thomashiemstra/fred/README.md

## Fred the robot arm

Table of Contents
-----------------
  * [Obstacle avoidance with reinforcement learning](#Obstacle-avoidance-with-reinforcement-learning)
  * [Algorithm details](#Algorithm-details)
  * [Deploying in the real world with machine vision](#Deploying-in-the-real-world-with-machine-vision)
  * [Videos](#Videos)
  * [Inverse kinematics](#Inverse-kinematics)
  * [Record and play back with a controller](#Record-and-play-back-with-a-controller)
  * [Motion tracking](#Motion-tracking)
  * [Physical robot details](#Physical-robot-details)
  * [Control panel](#Control-panel)

## Obstacle avoidance with reinforcement learning
A quick overview can be seen in [this](https://www.youtube.com/watch?v=u2XVU5J9dac) youtube video  
Using deep reinforcement learning the robot can reach the goal whilst avoiding obstacles, it even outperforms a classical method (gradient descent). 

Gradient descent (left) vs trained agent (right):

<p float="left">
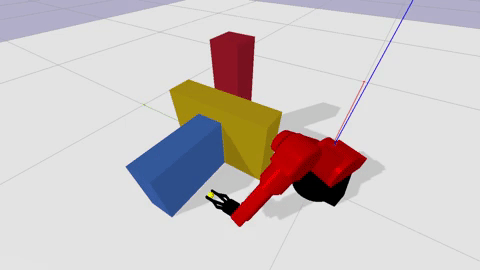
[picture p1: media/gd.gif]
  
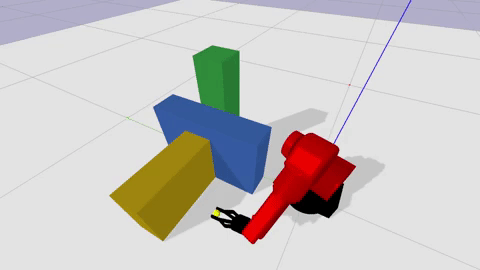
[picture p2: media/RL.gif]
  
</p>

With gradient descent the robot simply gets stuck. The trained agent manages to complete the task and can even be deployed on a real robot:



## Algorithm details
The goal is to get the robot to move from point A to point B without bumping into obstacles. 
A classical method is to use workspace potential fields and gradient descent, which is just a fancy name for 
pulling the robot towards the target and pushing it away from obstacles. However, the robot can get stuck when the net force is zero. 
The input for the gradient descent algorithm are 2 types of vectors: attractive vectors pointing towards the goal position and repulsive vectors pointing away from obstacles. 
These vectors originate from control points that have to be chosen manually:
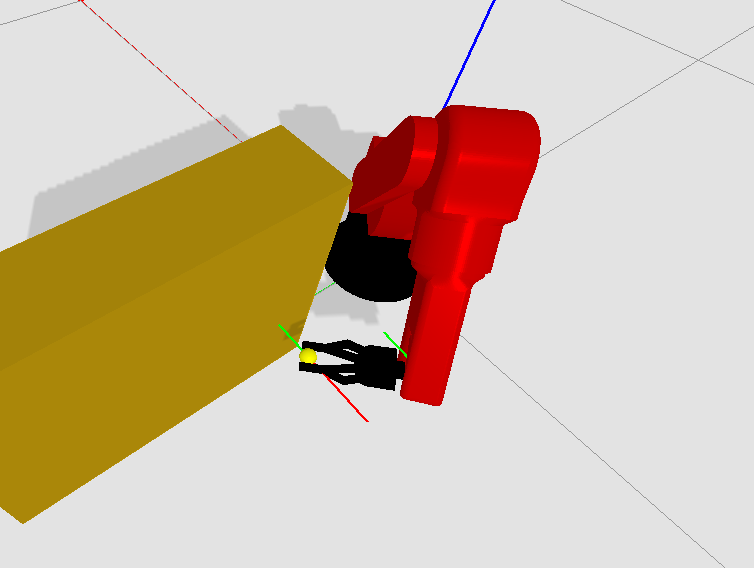
[picture p3: media/gradientDescentVectors.PNG]


If the net force on the robot is zero it gets stuck. I cannot "see" the obstacle except when it gets close to it.

This is where the idea of using reinforcement learning came from. We can give the agent the same inputs as gradient descent, 
but we can also make it aware of its current position and obstacles it's about to face, both their size and location. 
In theory, it could then plan its movement ahead and avoid the obstacle without getting stuck. The idea is to take the obstacles 
and turn them into an occupancy grid which is then fed into the network as an image using convolutional filters 
(here color corresponds to the height of the obstacle):
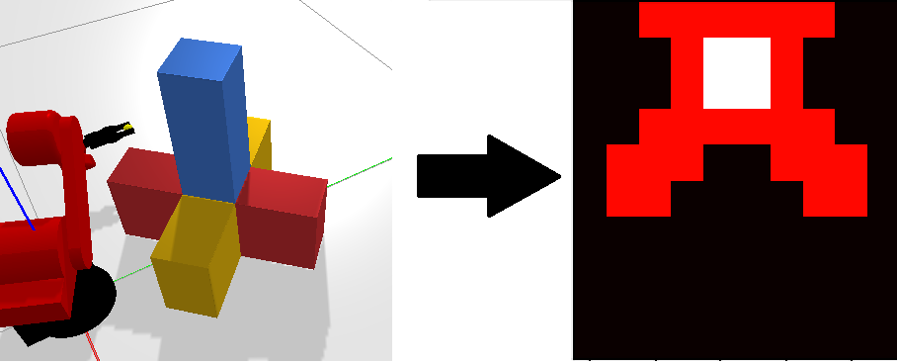
[picture p4: media/grid_conversion.png]


The attractive vectors, repulsive vectors, current location and the occupancy grid should be all the information needed to reach the goal, and it turns out it is. The neural network looks like this:
 
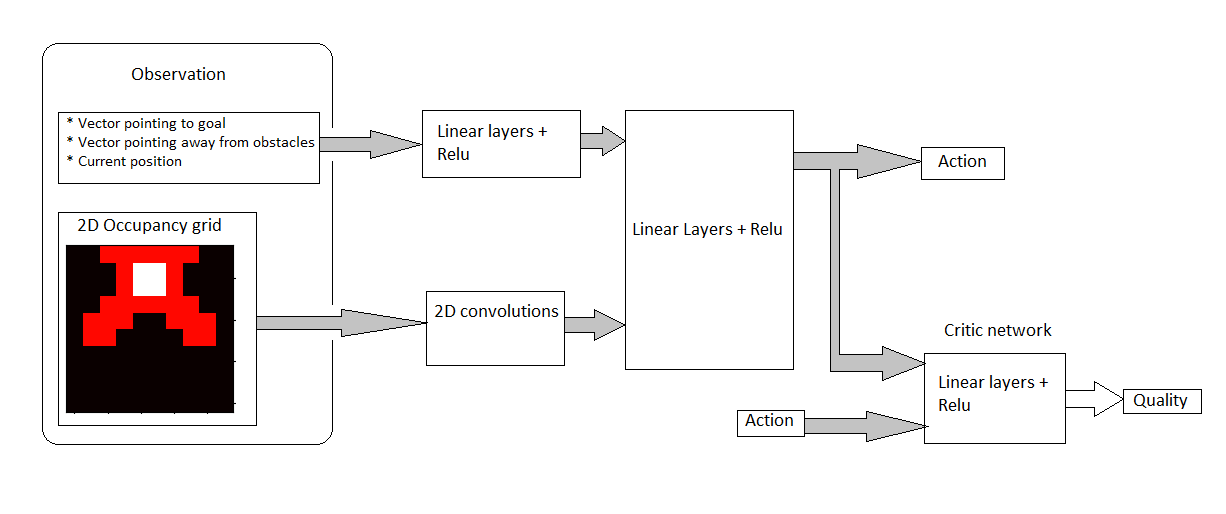
[picture p5: media/Network_structure.png]


The specific algorithm used here is the soft actor critic method ([Soft Actor Critic__ Haarnoja et al., 2018](https://arxiv.org/abs/1812.05905)). For the reinforcement learning the [tensorflow agents library](https://www.tensorflow.org/agents) is used

The agent controls the robot by updating its target position and orientation (pose). Giving the agent direct control over the angels of the robot would mean it has to figure out inverse kinematics as well, but since I have the algorithm for inverse kinematics there is no need for this.
This does mean however that the movement generated by the agent looks a little jagged, so the output of the agent is then used to generate a nice smooth curve using a B-spline:

Raw movement (left) vs smoothed movement (right):

<p float="left">
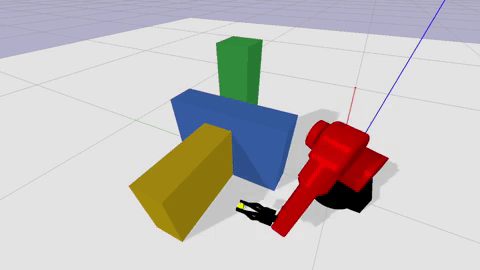
[picture p6: media/rl_raw.gif]
  
  
</p>

Here is the agent solving all the training scenarios:

<p float="left">
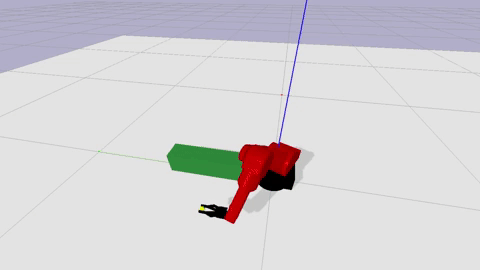
[picture p7: media/solve_1.gif]
  
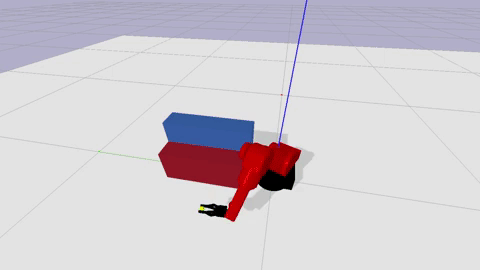
[picture p8: media/solve_2.gif]
  
</p>

Finally a few examples of the agent solving scenarios that were not part of the training set:
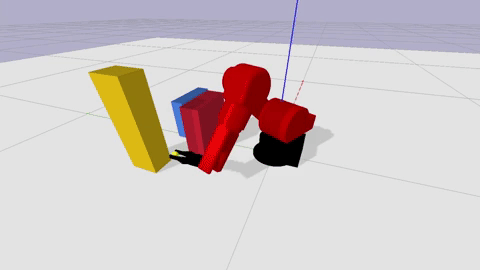
[picture p9: media/new_scenarios.gif]


## Deploying in the real world with machine vision
After converting the agent's output to a B-spline we have a simple path the robot has to follow. 
The hard part is converting the obstacles in the real world to the digital world. 
This is achieved by using machine vision, specifically opencv with the 
[aruco library](https://docs.opencv.org/4.5.2/d5/dae/tutorial_aruco_detection.html).
With the aruco library it is then possible to get the relative position and rotation of the markers and the board relative 
to the camera. Using linear algebra it is then trivial to get the position of the markers relative to the board. 
The board is at a known position relative to the robot which means we now know the position of the markers with respect 
to the robot, because each marker has a unique ID I have simply hard coded which obstacle is attached to which marker. 
For example marker 29 is a box of 12 by 12 by 35 centimeters. The camera image is then transformed:

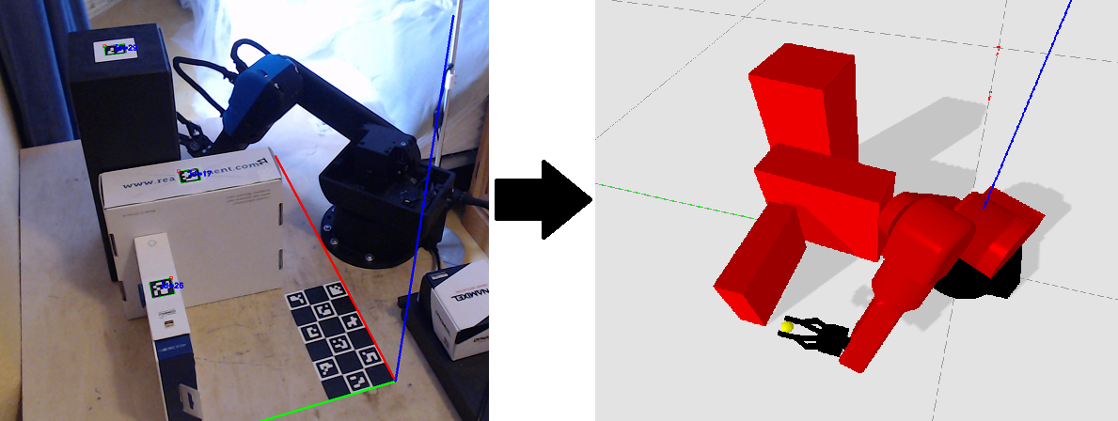
[picture p10: media/vision_conversion.png]


## Videos
[Reinforcement learning overview](https://www.youtube.com/watch?v=u2XVU5J9dac)  
[complete feature overview](https://www.youtube.com/watch?v=0Zqsso_n_9U)

## Inverse kinematics
The inverse kinematics is based on chapter 2 of "Lorenzo Sciavicco and Bruno Siciliano. Modelling and control of robot
manipulators. Springer Science & Business Media, 2012." For the mathematical details of the inverse kinematics of this robot see [ik_documentation.pdf](documentation/ik_documentation.pdf)

## Record and play back with a controller
Using inverse kinematics and an xbox controller the robot can be controlled directly:



## Motion tracking
The aruco markers can be tracked in real time allowing for vision based control of the robot:



## Physical robot details
The robot was designed in fusion360 and is printed on a Bambu Lab P1S. The design files can be found [here](https://a360.co/2PHQOEz). 
The robot uses Dynamixel servos, 
* Joint 1 is a xm430-W350 with a 3:1 gear reduction
* Joint 2 is a XM540-W270 with a 3:1 gear reduction
* Joint 3 is a xm430-W350
* Joint 4 is a xc430-w240
* Joint 5 is a xc430-w240
* Joint 6 is a xc430-w150
* the gripper uses a xl330-m288

The parts are printed in PLA, the arm between joints 2 and 3 in PETG-CF. The lower arm is reinforced with carbon fiber rods. The gear reduction is achieved using belt and
pulleys (and tensioners) which are normally used in 3d printers. The camera used is a C922 PRO HD STREAM WEBCAM.

## Running the tests
The tests don't need the robot, all hardware is faked. From the project root:
```
python -m unittest discover -s tests -t . -p "*test*.py"
```

## Control panel
Every part of the project is controlled using a REST API built with FLASK. A simple website is used to trigger steps of every process:
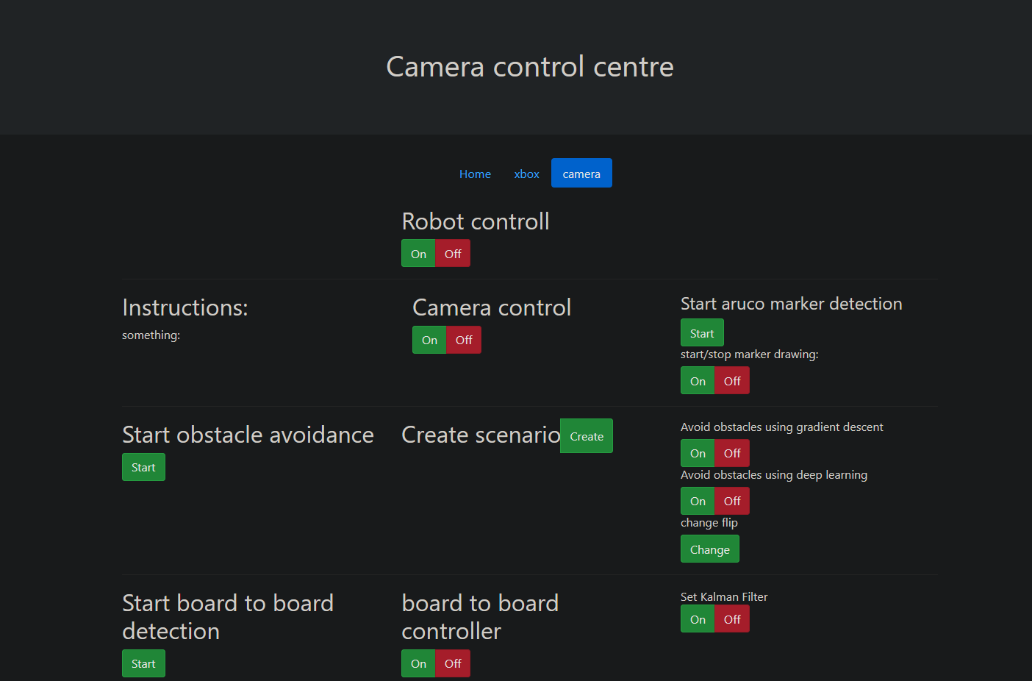
[picture p11: media/control_panel.PNG]


## Reinforcement learning training with docker
If you want to save yourself the pain of installing cuda, there is always docker. 

Training instructions:

build with: docker build -t thomas137/sac -f SaCDockerFile .

Run with:
docker run -it --gpus all --rm -v /home/thomas/PycharmProjects/fred/src:/tf/src   thomas137/sac

once in docker:
python src/reinforcementlearning/softActorCritic/soft_actor_critic.py --root_dir=test

░░░░░░░█▐▓▓░████▄▄▄█▀▄▓▓▓▌█ Epic code  
░░░░░▄█▌▀▄▓▓▄▄▄▄▀▀▀▄▓▓▓▓▓▌█  
░░░▄█▀▀▄▓█▓▓▓▓▓▓▓▓▓▓▓▓▀░▓▌█  
░░█▀▄▓▓▓███▓▓▓███▓▓▓▄░░▄▓▐█▌ level is so high  
░█▌▓▓▓▀▀▓▓▓▓███▓▓▓▓▓▓▓▄▀▓▓▐█  
▐█▐██▐░▄▓▓▓▓▓▀▄░▀▓▓▓▓▓▓▓▓▓▌█▌  
█▌███▓▓▓▓▓▓▓▓▐░░▄▓▓███▓▓▓▄▀▐█ much quality  
█▐█▓▀░░▀▓▓▓▓▓▓▓▓▓██████▓▓▓▓▐█  
▌▓▄▌▀░▀░▐▀█▄▓▓██████████▓▓▓▌█▌  
▌▓▓▓▄▄▀▀▓▓▓▀▓▓▓▓▓▓▓▓█▓█▓█▓▓▌█▌ Wow.  
█▐▓▓▓▓▓▓▄▄▄▓▓▓▓▓▓█▓█▓█▓█▓▓▓▐█
