thomashiemstra/fred/media/real_obstacles.PNG

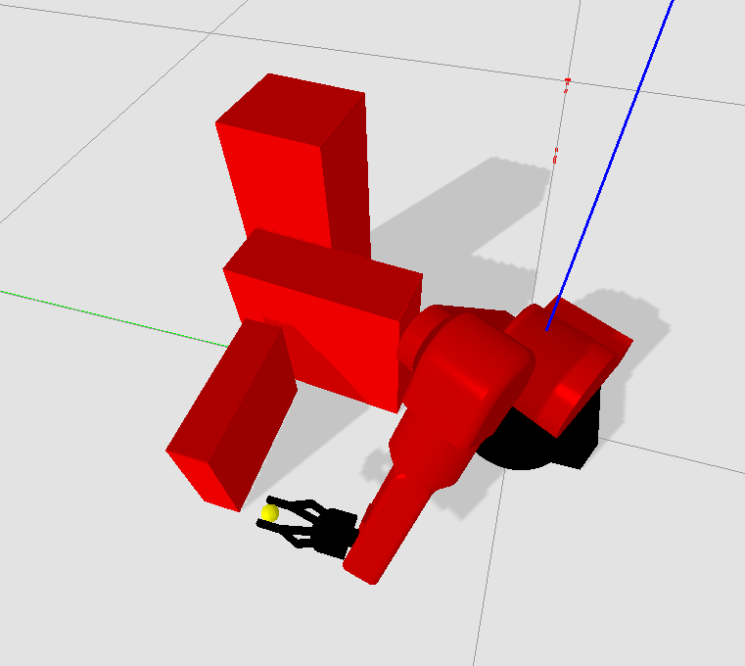
media/real_obstacles.PNG
