thomashiemstra/fred/media/robot_vision.PNG

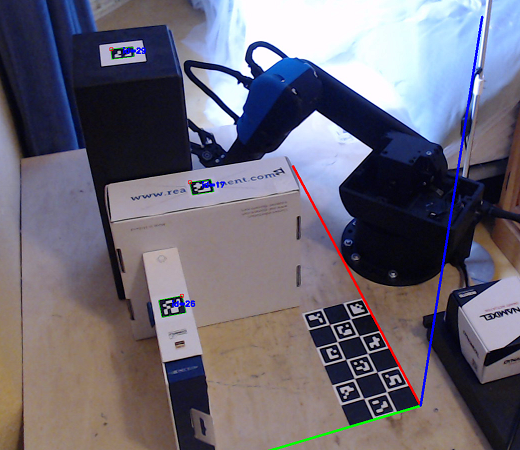
media/robot_vision.PNG
