thomashiemstra/fred/src/simulation/urdf/meshes/joint3.stl

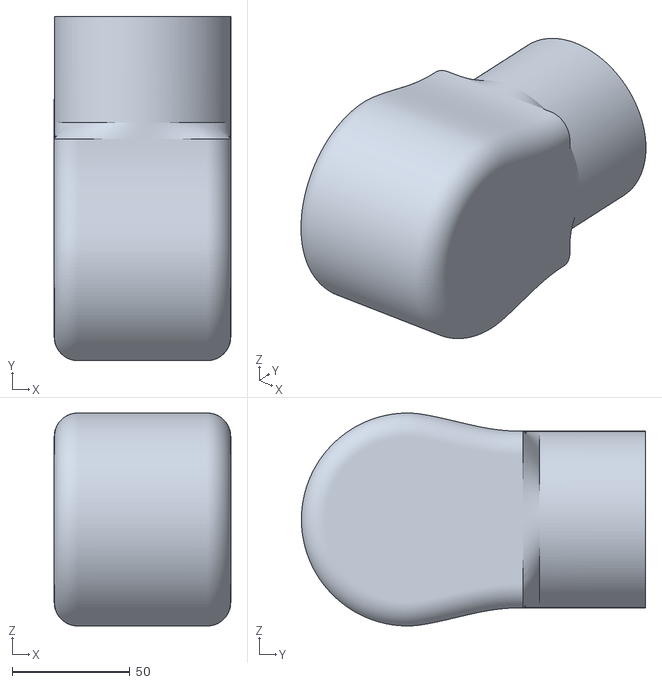
[picture p21: CAD file, 2021-06-20]
src/simulation/urdf/meshes/joint3.stl
75.0 x 146.2 x 90.5
