thomashiemstra/fred/src/simulation/urdf/meshes_fred/arm_lower_col.stl

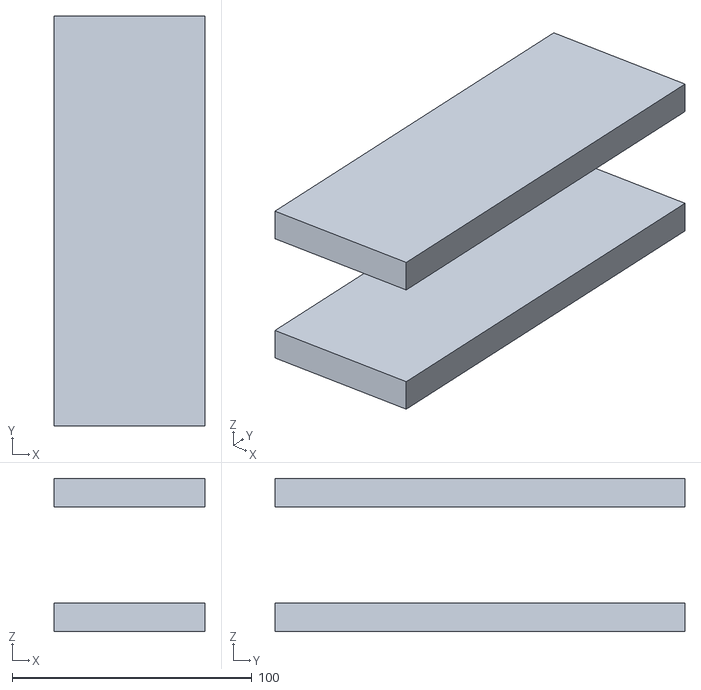
[picture p22: CAD file, 2019-05-25]
src/simulation/urdf/meshes_fred/arm_lower_col.stl
62.9 x 171.0 x 64.0
