thomashiemstra/fred/src/simulation/urdf/plane.obj

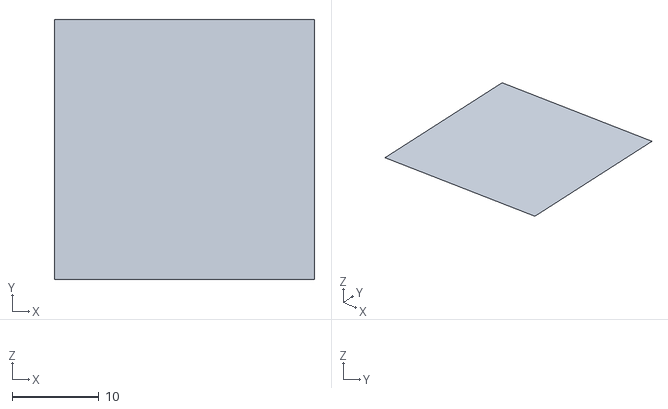
[picture p23: CAD file, 2019-05-25]
src/simulation/urdf/plane.obj
30.0 x 30.0 x 0
