thomashiemstra/fred/src/simulation/urdf/meshes/joint2.stl

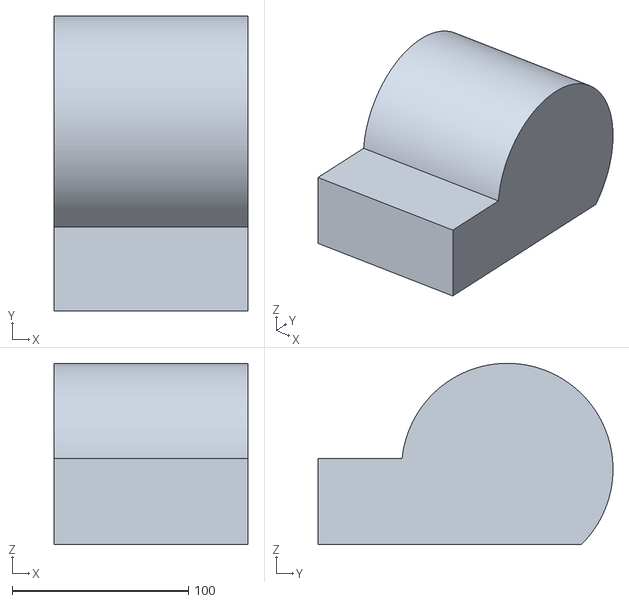
[picture p24: CAD file, 2021-05-14]
src/simulation/urdf/meshes/joint2.stl
110.0 x 167.4 x 102.9
