thomashiemstra/fred/src/simulation/urdf/meshes_fred/base.stl

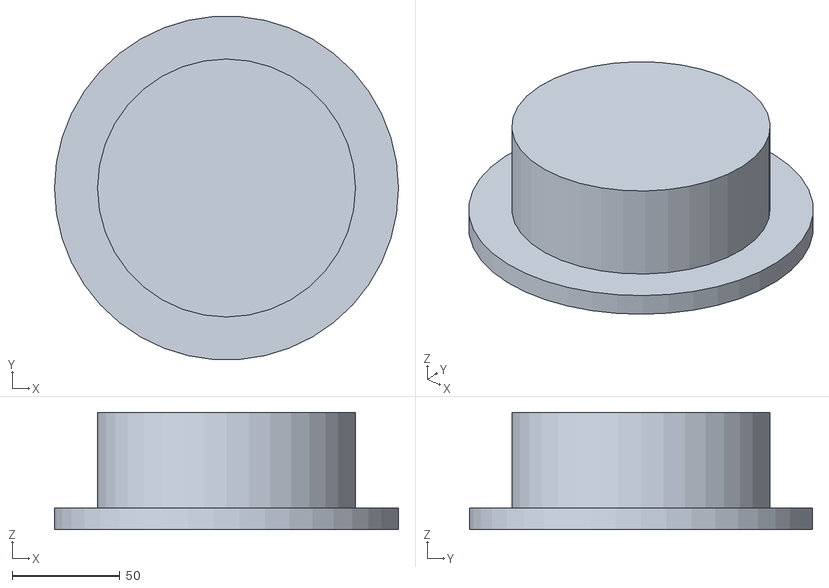
[picture p25: CAD file, 2019-05-25]
src/simulation/urdf/meshes_fred/base.stl
160.0 x 159.6 x 54.5
