thomashiemstra/fred/src/simulation/urdf/meshes/arm.stl

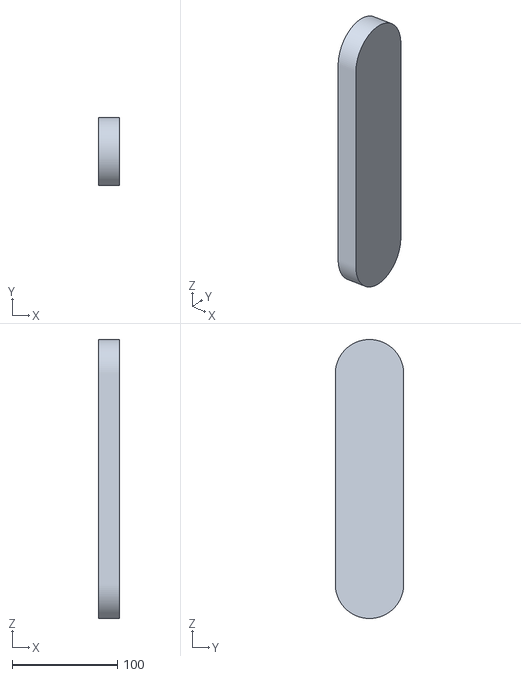
[picture p26: CAD file, 2021-05-14]
src/simulation/urdf/meshes/arm.stl
20.0 x 65.0 x 265.0
