thomashiemstra/fred/src/simulation/urdf/meshes_fred/gripper.stl

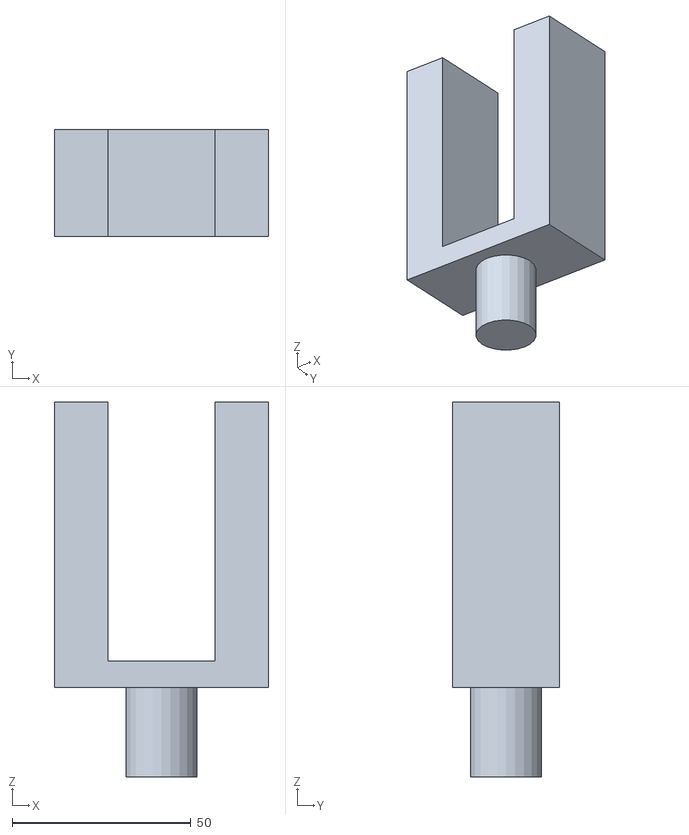
[picture p27: CAD file, 2019-05-25]
src/simulation/urdf/meshes_fred/gripper.stl
60.0 x 30.0 x 105.0
