thomashiemstra/fred/src/simulation/urdf/meshes/base.stl

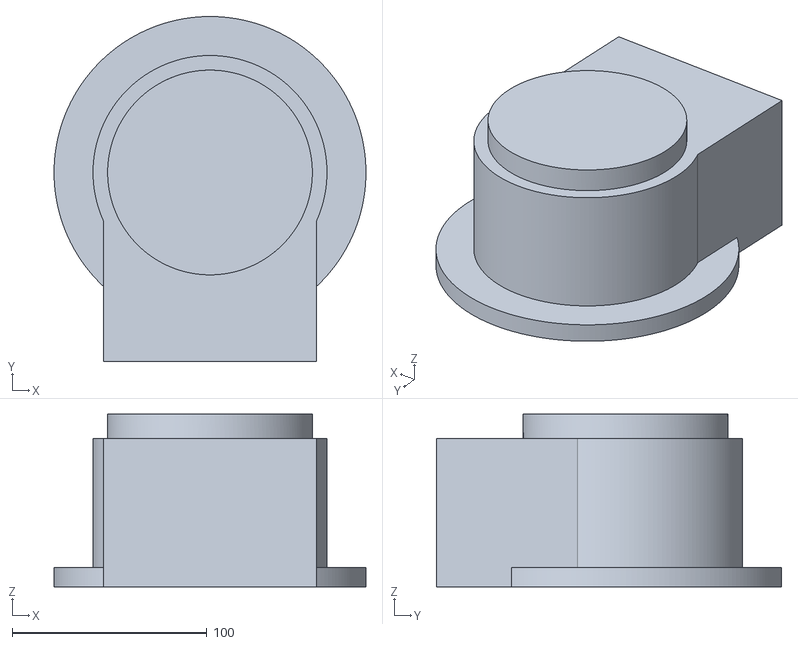
[picture p28: CAD file, 2021-05-14]
src/simulation/urdf/meshes/base.stl
160.0 x 176.9 x 88.6
