thomashiemstra/fred/src/simulation/urdf/meshes_fred/arm_lower.stl

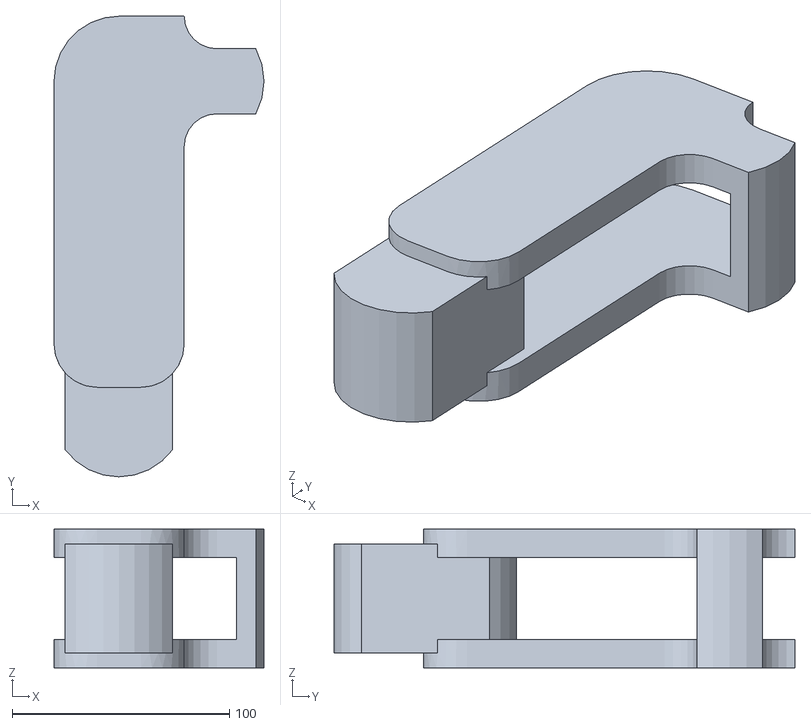
[picture p29: CAD file, 2019-05-05]
src/simulation/urdf/meshes_fred/arm_lower.stl
96.8 x 212.3 x 64.0
