thomashiemstra/fred/src/simulation/urdf/meshes/gripper.stl

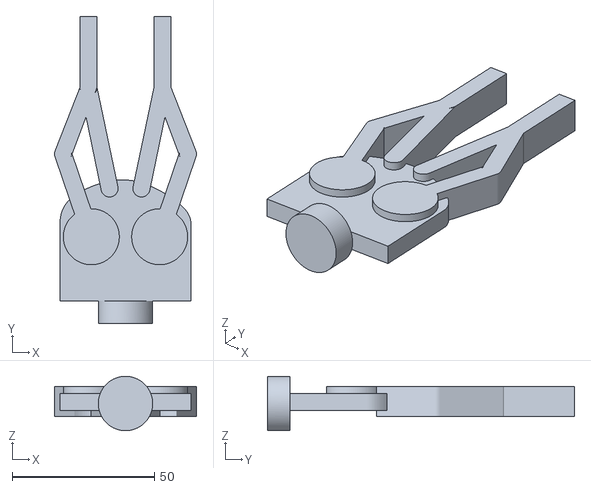
[picture p30: CAD file, 2021-05-14]
src/simulation/urdf/meshes/gripper.stl
49.9 x 108.0 x 19.1
