thomashiemstra/fred/src/simulation/urdf/meshes_fred/servo.stl

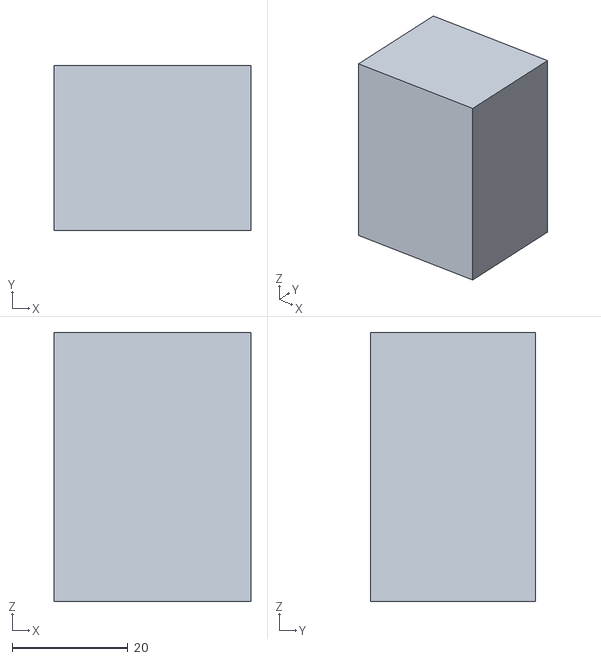
[picture p31: CAD file, 2019-05-05]
src/simulation/urdf/meshes_fred/servo.stl
34.0 x 28.5 x 46.5
