thomashiemstra/fred/src/simulation/urdf/meshes/gripper_servo.stl

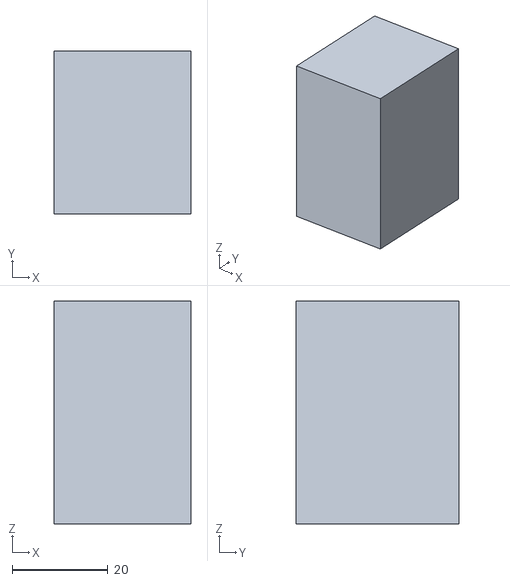
[picture p32: CAD file, 2021-05-14]
src/simulation/urdf/meshes/gripper_servo.stl
28.5 x 34.0 x 46.5
