thomashiemstra/fred/src/simulation/urdf/meshes_fred/base_plate.stl

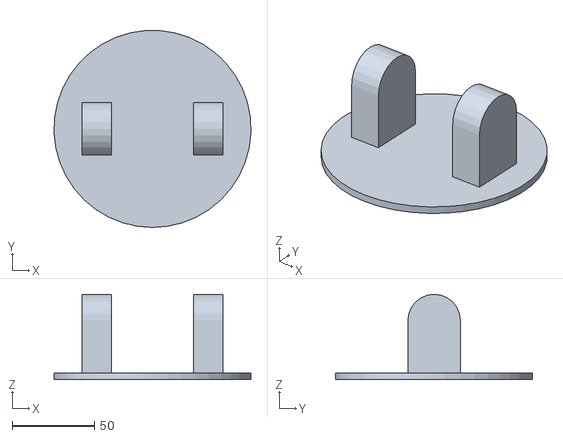
[picture p33: CAD file, 2019-05-05]
src/simulation/urdf/meshes_fred/base_plate.stl
119.9 x 119.8 x 52.0
