thomashiemstra/fred/src/simulation/urdf/meshes/joint4.stl

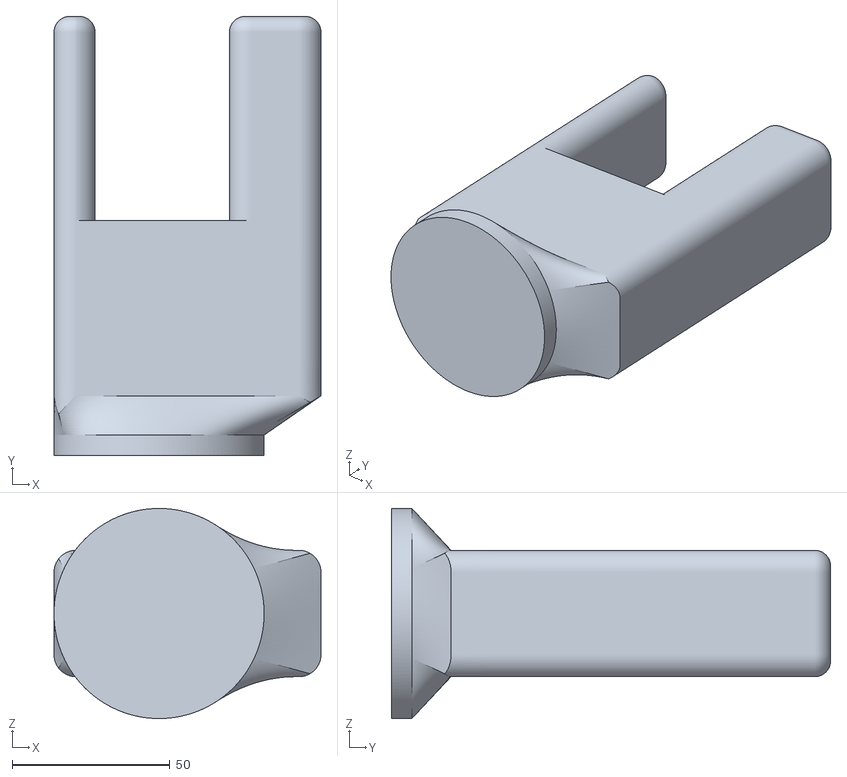
[picture p34: CAD file, 2021-05-14]
src/simulation/urdf/meshes/joint4.stl
84.5 x 139.0 x 66.5
