thomashiemstra/fred/src/simulation/urdf/meshes_fred/wrist.stl

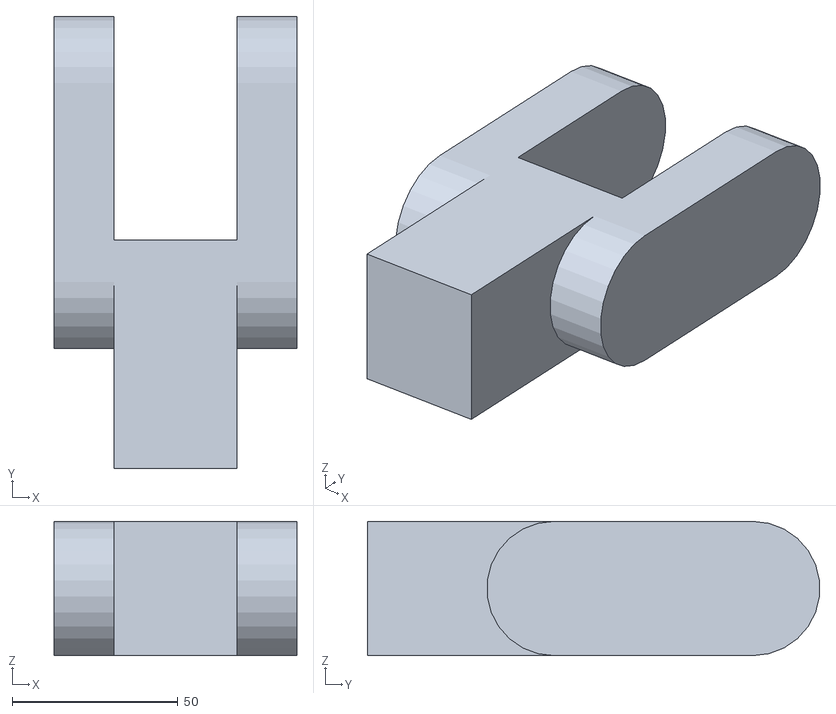
[picture p35: CAD file, 2019-05-05]
src/simulation/urdf/meshes_fred/wrist.stl
73.2 x 136.4 x 40.5
