thomashiemstra/fred/src/simulation/urdf/meshes_fred/arm_upper.stl

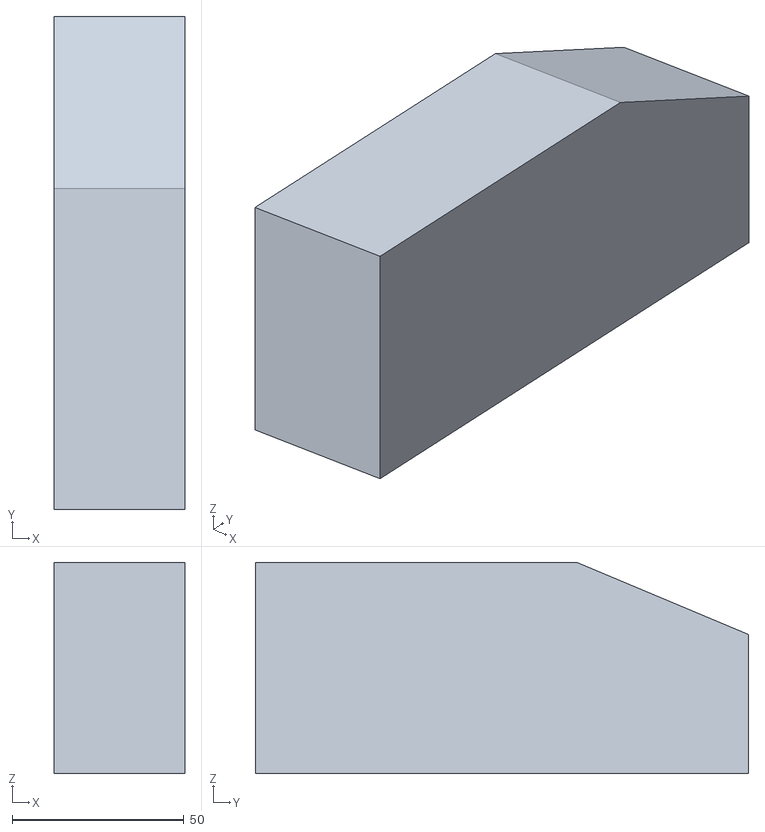
[picture p36: CAD file, 2019-05-05]
src/simulation/urdf/meshes_fred/arm_upper.stl
38.0 x 143.5 x 61.5
