thomashiemstra/fred/tests/camera_tests/resources/2_boards.png

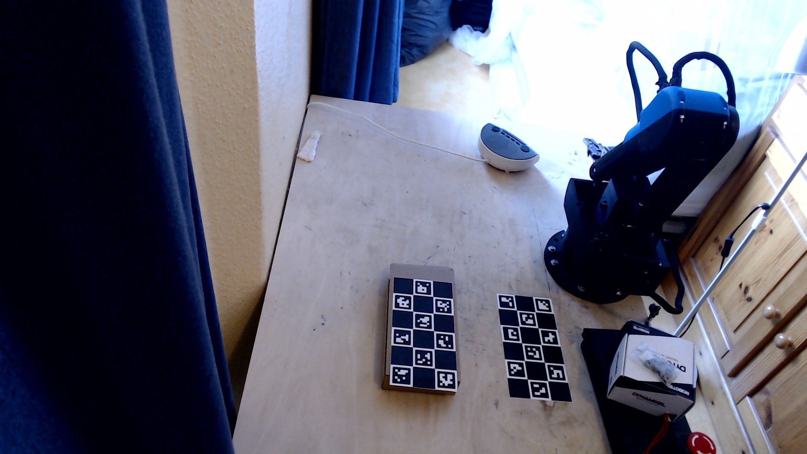
tests/camera_tests/resources/2_boards.png
