thomashiemstra/fred/tests/camera_tests/resources/image_no_board.png

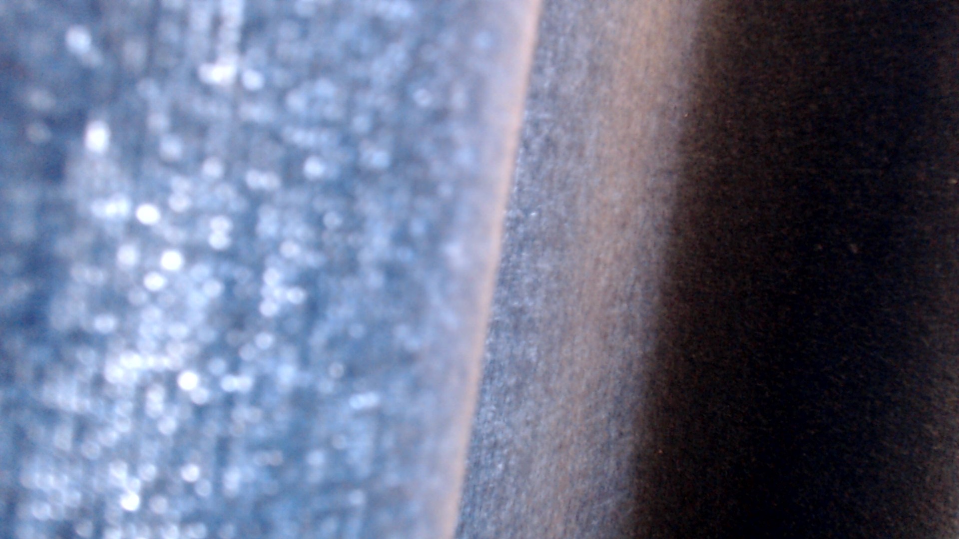
tests/camera_tests/resources/image_no_board.png
