thomashiemstra/fred/tests/camera_tests/resources/image_only_board.png

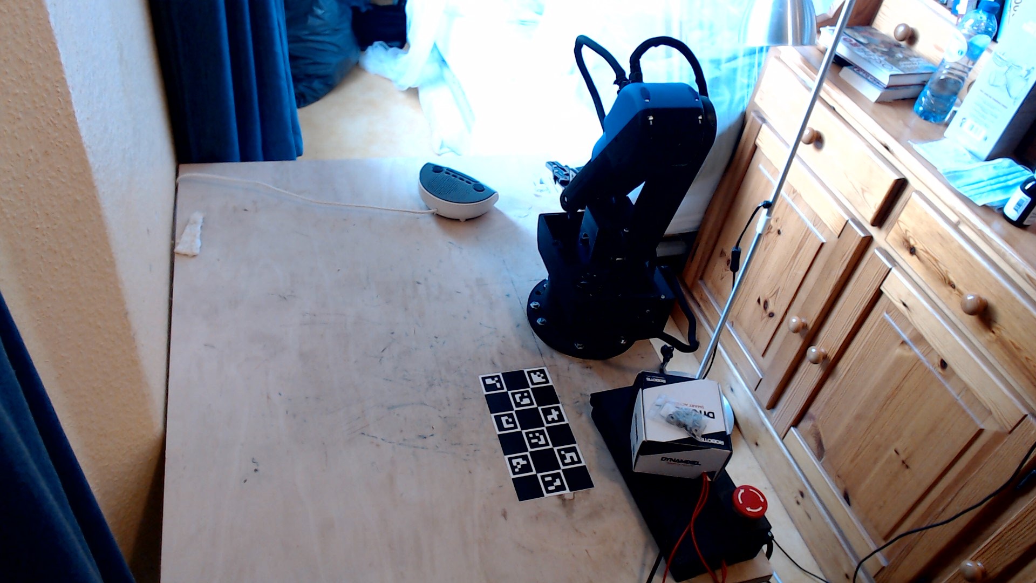
tests/camera_tests/resources/image_only_board.png
