thomashiemstra/fred/tests/camera_tests/resources/image_with_markers_and_board.png

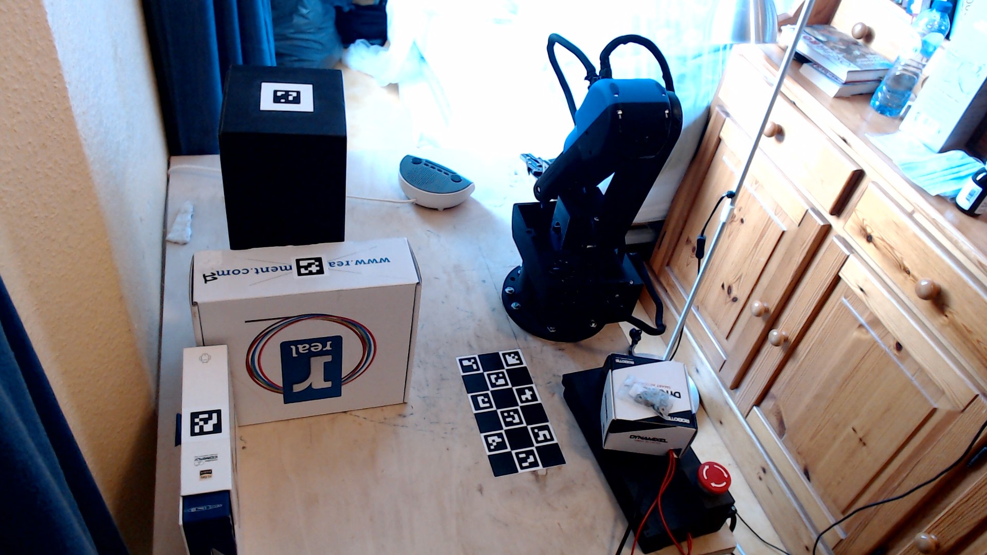
tests/camera_tests/resources/image_with_markers_and_board.png
