thomashiemstra/fred/(threads)

Thread 3 (2021-08-31):

How to contribute?

EmreSURK, 2021-08-31:
Great work!
The arm has reverse kinematics and it is cool.
Did you make all of these of your own?

The project does not have a contribution guide, how can I contribute to the project?

thomashiemstra, 2021-09-09:
Yes I made that function myself based on the book I linked. I'd suggest forking my project.
