thomashiemstra/fred/src/robot_controllers/dynamixel_robot/servo_config.yaml

# Configuration of the dynamixel servos of the robot, loaded by servo_config.py
#
# Every servo has:
#   name                        what the servo does
#   model                       the dynamixel model, for reference
#   bus                         the connector of the usb adapter, servos on different connectors can't hear each
#                               other's responses, so they are read separately
#   mode                        position, extended_position or current_based_position
#   positions: [first, last]    the servo positions (4096 per turn) of the ends of the range, last can be smaller than
#                               first when the servo is mounted the other way around
#   angles: [first, last]       the joint angles in degrees at those positions, or for the gripper:
#   states: [first, last]       the gripper states at those positions
#   offset                      added to the position, to calibrate the zero point (optional, default 0)
#   goal_current                the maximum current in mA in current_based_position mode (optional)
#   profile                     velocity and acceleration of the movement profile of the servo
#   pid                         the gains of the position controller of the servo
#   compensation                the static load compensation of the joint (optional, joints 2-5), the positions
#                               added to every target for gravity at the commanded pose, fitted by
#                               calibration/fit_static_load.py from the data of calibration/record_static_load.py,
#                               see static_compensation.py and Handover Gravity and Spring Compensation.md:
#                                 max_positions: 60                           the compensation is clipped to this
#                                 terms: {constant: 1.0, cos_q2: 12.0, ...}   coefficient per term in positions
#                                 up: {...}, down: {...}                      optional, per direction of the joint
#                               the terms: joint 2 constant, cos_q2, sin_q2, sin_phi, cos_phi, wrist_reach;
#                               joint 3 constant, sin_phi, cos_phi, wrist_reach; joint 4 constant, wrist_roll;
#                               joint 5 constant, wrist_pitch
#
# The spring between the servo 2 and servo 3 housings was removed on 23 October 2026 (it overloaded servo 3). A
# top level `spring` section (base_anchor: [radial, up] cm from the joint 2 axis, arm_anchor: [along, perp] cm from
# the joint 3 axis) is still accepted and adds the spring_dl term to joints 2 and 3, should a spring return.

# The robot is printed in PLA, which softens around 55-65C. A servo that is warmer than the warning temperature is
# logged, and the robot is stopped while all servos still work when one is warmer than the limit. The servos measure
# their temperature inside, the plastic around them is cooler. The servos shut down by themselves at their hardware
# temperature limit, 80C (70C for the gripper), and then just go limp.
temperature_warning: 55  # degrees celsius
temperature_limit: 60  # degrees celsius

servos:
  1:
    name: base
    model: XM430-W350
    bus: rs485
    mode: position
    positions: [1024, 3072]
    angles: [0, 180]
    offset: 346  # measured in the jig at 90 degrees, raw 2394
    profile: {velocity: 250, acceleration: 100}
    pid: {p: 1500, i: 0, d: 0}
  2:
    name: shoulder
    model: XM540-W270
    bus: rs485
    mode: position
    positions: [1024, 3072]
    angles: [0, 180]
    offset: -550  # measured in the jig at 0 degrees, raw 474
    profile: {velocity: 500, acceleration: 500}
    pid: {p: 1400, i: 0, d: 250}
  3:
    name: elbow
    model: XM430-W350
    bus: rs485
    mode: position
    positions: [3072, 1024]
    angles: [-90, 90]
    profile: {velocity: 150, acceleration: 50}
    pid: {p: 3000, i: 0, d: 350}
  4:
    name: wrist 1
    model: XC430-W240
    bus: ttl
    mode: position
    positions: [0, 4096]
    angles: [-180, 180]
    offset: 3  # measured in the jig at 0 degrees, raw 2051
    profile: {velocity: 300, acceleration: 100}
    pid: {p: 1100, i: 0, d: 550}
  5:
    name: wrist 2
    model: XC430-W240
    bus: ttl
    mode: position
    positions: [0, 4096]
    angles: [-180, 180]
    offset: 55  # measured in the jig at 0 degrees, raw 2103
    profile: {velocity: 300, acceleration: 100}
    pid: {p: 3300, i: 0, d: 500}
  # an XC330-T288-T on the 12 V bus since 11 November 2026 (rated 6.5-12 V, current limit 910 mA, 1 mA per unit,
  # 1.0 N.m at 12 V), bolted to servo 5. Before it an XL330-M288 on a 5 V step-down converter, which switched off when
  # the servo braked (its energy pushed the 5 V line up) and later got 11.7 V from a mis-set converter, which broke its
  # motor driver. Current-based position mode, so it never draws more than the goal current; the goal current and the
  # profile are those of the XL330 until calibration/wrist_roll_limits.py has measured the XC330. The gains: with the
  # P of 1200 it came with and D 0 it swung +-115 positions around every target without stopping (11 November); without
  # D it already oscillates from P 600, with D 400 it rests within 3 positions of the target up to P 800 at 5 mA.
  # The positions have to be calibrated for the new mounting
  6:
    name: wrist 3
    model: XC330-T288-T
    bus: ttl
    mode: current_based_position
    positions: [0, 4096]
    angles: [-180, 180]
    goal_current: 300
    profile: {velocity: 200, acceleration: 50}
    pid: {p: 600, i: 0, d: 400}
  # an XC330-T288-T on the 12 V bus since 11 November 2026, before it an XL330-M288.
  # NOT CALIBRATED: the positions are still those of the XL330 and the new servo sits far outside them (3999 on 11
  # November), so don't open or close the gripper until its open and closed positions are measured.
  # 0 is open and 100 is closed. The XC330 makes about 3 times the torque of the XL330 per mA (1.136 against 0.354
  # N.m/A), so 150 mA squeezes about as hard as the 400 mA of the XL330 did (0.17 against 0.14 N.m); its current
  # limit is 910 mA. With the XL330: when an object blocked the gripper it squeezed with about 2 mA per position the
  # target was beyond the object (with p=500), up to the goal current, see GRIPPER_MAX_LEAD of the xbox controller
  7:
    name: gripper
    model: XC330-T288-T
    bus: ttl
    mode: current_based_position
    positions: [1024, 2048]
    states: [0, 100]
    goal_current: 150
    profile: {velocity: 50, acceleration: 50}
    pid: {p: 600, i: 0, d: 400}  # those of servo 6, see there
