thomashiemstra/fred/src/robot_controllers/dynamixel_robot/gravity_compensation.py

from __future__ import print_function

import inspect
import json
import os

import keyboard
from numpy import pi

# root window
from src import global_constants
from src.robot_controllers.dynamixel_robot.dynamixel_robot_controller import DynamixelRobotController


class Servo2Manager:

    def __init__(self) -> None:
        self.robot = DynamixelRobotController("COM3", global_constants.dynamixel_robot_config)

        self.servo_id = 2
        self.servo = self.robot.servo2

        self.angle2 = 0.0
        self.angle3 = 0.5
        self.step_size = 0.1

        self.servo_2offsets_dict = {}
        self.servo_3offsets_dict = {}
        self.servo_3_direct_offsets_dict = {}

        keyboard.add_hotkey('s', lambda: self.switch_servo())
        keyboard.add_hotkey('up', lambda: self.move_current_servo_up())
        keyboard.add_hotkey('down', lambda: self.move_current_servo_down())
        keyboard.add_hotkey('space', lambda: self.record_offset())
        keyboard.add_hotkey('p', lambda: self.print_offset_json())

    def start(self):
        self.robot.enable_servos()
        self.robot.move_servo(3, self.angle3 * pi)
        self.robot.move_servo(2, self.angle2 * pi)
        keyboard.wait()

    def print_offset_json(self):
        print(json.dumps(self.servo_2offsets_dict))
        print(json.dumps(self.servo_3offsets_dict))
        print(json.dumps(self.servo_3_direct_offsets_dict))

    def record_offset(self):
        current_positions = self.robot.get_current_positions()
        servo2_target = self.robot.servo2.target_position
        servo2_offset = current_positions[2] - servo2_target

        servo3_target = self.robot.servo3.target_position
        servo3_offset = current_positions[3] - servo3_target

        # go from 0.300000001 to 0.3, floats....
        angle2rounded = round(self.angle2, 2)
        angle3rounded = round(self.angle3, 2)

        print(angle2rounded, angle3rounded, servo2_offset, servo3_offset)

        angle3_dict = {} if angle2rounded not in self.servo_2offsets_dict else self.servo_2offsets_dict[angle2rounded]
        angle3_dict[angle3rounded] = int(servo2_offset)
        self.servo_2offsets_dict[angle2rounded] = angle3_dict

        angle2_dict = {} if angle3rounded not in self.servo_3offsets_dict else self.servo_3offsets_dict[angle3rounded]
        angle2_dict[angle2rounded] = int(servo3_offset)
        self.servo_3offsets_dict[angle3rounded] = angle2_dict

        combined_angle = round(angle2rounded + angle3rounded - 0.5, 2)
        angle2_list = [] if combined_angle not in self.servo_3_direct_offsets_dict else self.servo_3_direct_offsets_dict[combined_angle]
        angle2_list.append(int(servo3_offset))
        self.servo_3_direct_offsets_dict[combined_angle] = angle2_list

    def switch_servo(self):
        if self.servo_id == 2:
            self.servo_id = 3
            self.servo = self.robot.servo3
            print("switched to servo3")
        elif self.servo_id == 3:
            self.servo_id = 2
            self.servo = self.robot.servo2
            print("switched to servo2")

    def move_current_servo_up(self):
        if self.servo_id == 2:
            self.angle2 = self.angle2 + self.step_size if self.angle2 < 1 else self.angle2
            self.robot.move_servo(self.servo_id, self.angle2 * pi)
        if self.servo_id == 3:
            self.angle3 = self.angle3 + self.step_size if self.angle3 < 0.5 else self.angle3
            self.robot.move_servo(self.servo_id, self.angle3 * pi)

    def move_current_servo_down(self):
        if self.servo_id == 2:
            self.angle2 = self.angle2 - self.step_size if self.angle2 > 0 else self.angle2
            self.robot.move_servo(self.servo_id, self.angle2 * pi)
        if self.servo_id == 3:
            self.angle3 = self.angle3 - self.step_size if self.angle3 > -0.5 else self.angle3
            self.robot.move_servo(self.servo_id, self.angle3 * pi)


manager = Servo2Manager()
manager.start()
