thomashiemstra/fred/tests/utils_tests/servo_test.py

import unittest

from src.global_constants import EXTENDED_POSITION_CONTROL
from src.robot_controllers.dynamixel_robot.servo import Servo, Servo2, Servo3, ServoWithOffsetFunction
from numpy import pi


class ServoTest(unittest.TestCase):

    def test_get_angle_from_position_1(self):
        # given
        servo = Servo(0, 100, 0, 100, EXTENDED_POSITION_CONTROL)

        # when
        angle = servo.get_angle_from_position(50)

        # then
        self.assertEqual(50, angle, "got a wrong angle, it should maps 1 to 1 from 50 to 50")

    def test_get_angle_from_position_2(self):
        # given
        servo = Servo(0, 100, 0, 200, EXTENDED_POSITION_CONTROL)

        # when
        angle = servo.get_angle_from_position(100)

        # then
        self.assertEqual(200, angle, "got a wrong angle, it should maps 1 to 2 from 100 to 200")

    def test_get_angle_from_position_3(self):
        # given
        servo = Servo(0, 50, 0, 100, EXTENDED_POSITION_CONTROL)

        # when
        angle = servo.get_angle_from_position(25)

        # then
        self.assertEqual(50, angle, "got a wrong angle, it should map 1 to 2 from 25 to 50")

    def test_set_target_position_from_angle_1(self):
        # given
        servo = Servo(0, 100, 0, 100, EXTENDED_POSITION_CONTROL)

        # when
        servo.set_target_position_from_angle(50)

        # then
        target = servo.target_position
        self.assertEqual(50, target, "got a wrong target, it should maps 1 to 1 from 50 to 50")

    def test_set_target_position_from_angle_2(self):
        # given
        servo = Servo(0, 50, 0, 100, EXTENDED_POSITION_CONTROL)

        # when
        servo.set_target_position_from_angle(40)

        # then
        target = servo.target_position
        self.assertEqual(20, target, "got a wrong target")

    def test_set_target_position_from_angle_3(self):
        # given
        servo = Servo(0, 100, 0, 200, EXTENDED_POSITION_CONTROL)

        # when
        servo.set_target_position_from_angle(50)

        # then
        target = servo.target_position
        self.assertEqual(25, target, "got a wrong target")

    def test_constant_offset_angle_conversion(self):
        # given
        servo = Servo(0, 100, 0, pi, EXTENDED_POSITION_CONTROL, offset=10)

        # when
        angle = pi/2
        servo.set_target_position_from_angle(angle)

        # then
        self.assertEqual(60, servo.target_position)

    def test_constant_offset_angle_conversion_back_to_angle(self):
        # given
        servo = Servo(0, 100, 0, 100, EXTENDED_POSITION_CONTROL, offset=10)

        # when
        angle = 30
        servo.set_target_position_from_angle(angle)

        # then
        servo_target = servo.target_position
        self.assertEqual(angle, servo.get_angle_from_position(servo_target))

    def test_reversed_servo_with_offset_round_trip(self):
        # mounted the other way around: the smallest angle is at the highest position
        servo = Servo(3072, 1024, -pi / 2, pi / 2, EXTENDED_POSITION_CONTROL, offset=-100)
        servo.set_target_position_from_angle(-pi / 2)
        self.assertEqual(3072 - 100, servo.target_position)
        servo.set_target_position_from_angle(pi / 2)
        self.assertEqual(1024 - 100, servo.target_position)
        servo.set_target_position_from_angle(pi / 4)
        self.assertEqual(1536 - 100, servo.target_position)
        self.assertAlmostEqual(pi / 4, servo.get_angle_from_position(servo.target_position), places=3)

    def test_angle_outside_the_range_goes_to_the_end_of_the_range(self):
        servo = Servo(1024, 3072, 0, pi, EXTENDED_POSITION_CONTROL, offset=10)
        servo.set_target_position_from_angle(2 * pi)
        self.assertEqual(3072 + 10, servo.target_position)
        servo.set_target_position_from_angle(-pi)
        self.assertEqual(1024 + 10, servo.target_position)

        reversed_servo = Servo(3072, 1024, -pi / 2, pi / 2, EXTENDED_POSITION_CONTROL)
        reversed_servo.set_target_position_from_angle(pi)
        self.assertEqual(1024, reversed_servo.target_position)

    def test_position_outside_the_range_gives_the_angle_at_the_end_of_the_range(self):
        servo = Servo(1024, 3072, 0, pi, EXTENDED_POSITION_CONTROL, offset=10)
        self.assertEqual(pi, servo.get_angle_from_position(4000))
        self.assertEqual(0, servo.get_angle_from_position(-20))
        reversed_servo = Servo(3072, 1024, -pi / 2, pi / 2, EXTENDED_POSITION_CONTROL)
        self.assertEqual(pi / 2, reversed_servo.get_angle_from_position(0))
        self.assertEqual(-pi / 2, reversed_servo.get_angle_from_position(4000))

    def test_target_position_is_a_whole_number(self):
        servo = Servo(0, 4095, 0, pi, EXTENDED_POSITION_CONTROL)
        servo.set_target_position_from_angle(1.0)
        self.assertIsInstance(servo.target_position, int)
        self.assertEqual(round(4095 / pi), servo.target_position)

    def test_clamp_position_includes_the_offset(self):
        servo = Servo(1024, 3072, 0, pi, EXTENDED_POSITION_CONTROL, offset=50)
        self.assertEqual((1074, 3122, 2000), (servo.clamp_position(0), servo.clamp_position(5000),
                                              servo.clamp_position(2000)))
        self.assertIsInstance(servo.clamp_position(2000), int)

    def test_clamp_position_of_reversed_servo(self):
        servo = Servo(3072, 1024, -pi / 2, pi / 2, EXTENDED_POSITION_CONTROL, offset=-24)
        self.assertEqual((1000, 3048, 2000), (servo.clamp_position(0), servo.clamp_position(5000),
                                              servo.clamp_position(2000)))


class ServoWithOffsetFunctionTest(unittest.TestCase):

    def test_offset_function(self):
        # given
        def offset_function(all_angles):
            return all_angles[0]
        servo = ServoWithOffsetFunction(0, 100, 0, pi, EXTENDED_POSITION_CONTROL, offset_function, offset_function)

        # when
        servo.set_target_position_from_angle(pi/2, [10.0, 0.0, 0.0, 0.0, 0.0, 0.0, 0.0])

        # then
        target = servo.target_position
        self.assertEqual(40, target, "got a wrong target")

    def test_direction_of_movement_selects_the_offset_function(self):
        servo = ServoWithOffsetFunction(0, 100, 0, pi, EXTENDED_POSITION_CONTROL, lambda angles: 10,
                                        lambda angles: -10)
        all_angles = [0.0] * 7
        servo.set_target_position_from_angle(pi / 2, all_angles)
        self.assertEqual(50 - 10, servo.target_position)
        servo.set_target_position_from_angle(pi / 4, all_angles)
        self.assertEqual(25 + 10, servo.target_position)
        # standing still keeps the last direction
        servo.set_target_position_from_angle(pi / 4, all_angles)
        self.assertEqual(25 + 10, servo.target_position)
        # without the other angles there is no compensation
        servo.set_target_position_from_angle(pi / 2)
        self.assertEqual(50, servo.target_position)

    def test_no_function(self):
        self.assertRaises(ValueError, ServoWithOffsetFunction, 0, 1, 0, 1, EXTENDED_POSITION_CONTROL, None, None)
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
