thomashiemstra/fred/src/robot_controllers/dynamixel_robot/gripper_test.py

"""
Test script that moves the physical gripper (servo 7), the other servos are not enabled. Run it from the project root:
    python -m src.robot_controllers.dynamixel_robot.gripper_test

1. closes the gripper without an object, to check whether it pushes against its mechanical end at the closed end
2. optionally squeezes an object with increasing goal currents (up to 1500mA) and reports the current, the
   position, the temperature and the hardware errors. It stops at a hardware error or when the gripper gets warm
3. squeezes an object with the target a few states beyond the object, like the xbox controller does, to check how
   much of the goal current that uses
4. disables the torque of the gripper

The gripper is open at state 0 and closed at state 100.

Ctrl+C disables the torque of the gripper and exits.
"""
import logging
import sys
from time import sleep, perf_counter

from src.robot_controllers.dynamixel_robot import dynamixel_x_config as cfg
from src.robot_controllers.dynamixel_robot.dynamixel_robot_controller import ARM_IDS, GRIPPER_ID
from src.robot_controllers.dynamixel_robot.dynamixel_utils import setup_dynamixel_handlers, to_signed
from src.robot_controllers.dynamixel_robot.servo_config import load_servo_config
from src.robot_controllers.dynamixel_robot.servo_handler import ServoHandler
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
