thomashiemstra/fred/(commit log)

2019-01-28 enable setting PID and some code cleanup
2019-01-28 fewer steps per second improve stability of the path
    [main.py]
2019-01-31 Dank ass PID settings
2019-02-02 new PID settings
2019-02-02 Dirty hack to fix z value during line movements
    [main.py]
2019-02-03 Prevent NPE in case of a failed read
    [servo.py]
2019-02-06 I can't help but messing with PID values
2019-02-13 new functions so we can go from current angles to target poase
2019-02-26 status button for the frontend (and some more experiments)
2019-03-12 add buttons to start and stop the robot
2019-03-23 camera mounted, new end effector length.
2019-03-23 implement servo offset
2019-03-23 Set PID values of the wrist servos
2019-03-24 Initial camera capture class
2019-03-24 on/off button for the camera
2019-03-25 better error handling and documentation
    [movement_utils.py]
2019-03-29 also return the vectors in the new coordinate frame
2019-04-02 actually document the inverse kinematics
2019-04-04 rename for clarity, we are dealing with a robot, not just a servo controller
2019-04-04 remove broken code, this is NOT how math works...
    [linalg_utils.py, movement_utils_tests.py]
2019-04-06 also plot the knot points
2019-04-06 shift the spline curve if it doesn't start at start_pose
    Because of fitting the spline curve might not hit the start and end knot point
    So the curve is shifted to always start at start_pose. And it returns the actual end+pose
    [movement_utils.py]
2019-04-07 better PID and speed values
2019-04-07 even more tuning! now with improved pid, speed and offsets!
2019-04-08 implement (hacky) PID testing
2019-04-08 move from_current_angles_to_pose out of the servo_controller class
2019-04-09 offsets can be handled by the dynamixels themselves with HomingOffset
2019-04-09 added endpoints and buttons for center mode
2019-04-10 let's document the homing offsets of the servos just in case
2019-04-11 fix failing unit tests
    [movement_utils_tests.py]
2019-04-11 basic inverse kinematics tests
2019-04-13 refactor get_angles_center, remove code duplication
    the one time I duplicate code it immediately introduces a bug... that'll show me.
    [movement_utils.py]
2019-04-13 some more PID tuning
2019-05-05 add urdf file for the robot arm
    [arm_lower.stl, arm_upper.stl, base.stl, base_plate.stl, fred.urdf, fred.xacro, gripper.stl, servo.stl]
2019-05-05 add actual fred.urdf compiled from the xacro file, oops.
    [fred.urdf]
2019-05-07 Fix camera issues
2019-05-25 first step towards a simulation
    [arm_lower.stl, arm_lower_col.stl, arm_upper.stl, base.stl, base_plate.stl, fred.urdf, fred.xacro, fred_with_spheres.urdf]
2019-05-26 first step towards obstacle avoidance
    [global_constants.py]
2019-08-10 Update PID test to work on linux
2019-08-10 Allow using the simulation instead of the real robot, also make it configurable with a flag
    Who knew just importing matplotlib would wreck pybullet's GUI!?
    [fred.urdf, fred.xacro]
2019-08-25 fix reset_servo to also reset the target positions of the motors
2019-09-01 rename to control point ids since these are the ids from the robot urdf that indicate the control points
2019-09-04 first (half-assed) attempt at servo speed limiting
2019-09-06 Add speed limit for the servos
2019-09-07 add ability to rotate obstacle around the world z-axis
2019-09-17 simple script to move servo from python code through and arduino
2019-09-17 let's see if this works on Linux, because it does NOT work on windows at all
    [arduino_experiment.py]
2019-09-19 propagate the dpad buttons and cleanup
2019-09-28 fix destroy, let's use the provided physics client
    [obstacle.py]
2019-10-08 add frontend button to clear all recorded moves and positions
2019-10-09 rename to servo controller because it could be the dynamixel one OR the simulated one
2019-10-09 Implementing a gripper for the robot
    it moves very jittery, this has to be fixed.....
    [dynamixel_robot_controller.py, xbox_control_resource.py, xbox_robot_controller.py]
2019-10-09 a little less jitter, but it still sucks
    [xbox_robot_controller.py]
2019-10-10 add time taken to move servos command to adjust the sleep time for it
2019-10-10 better gripper length
2019-10-11 update homing offsets
2020-01-27 First attempt at radius based workspace limits
    It makes far more sense to restrict the robot arm to spheres rather than boxes.
    After all it's reach is circular, not rectangular.
2020-04-18 Use raw obs for current angles as well
    Saves us having to convert them back
2020-04-24 First kinematics test
    Can't believe I haven't done this
2020-05-30 Set up framework for custom SAC training
2020-06-01 remove filtering of "invalid" transitions
    this was put in place for infinite horizon problems where the episode just ends at some point.
    We actually have a well defined end with a final score we care about.
2020-06-09 draw charuco board
    more complex is better!
2020-06-09 camera calibration done right
2020-06-18 add main to test the camera
2020-06-18 calibration vals to json!
2020-06-19 charuco board generation script
2020-06-20 move aruco dictionary to camera module
    let's not add a global dependency on opencv
2020-06-20 use separate dicts for the board and the markers
    this way we never have any collisions when detection markers and charuco boards at the same time
2020-06-23 an attempt at unifying the capture config across camera classes
2020-07-27 fix xbox robot control
    [global_constants.py]
2020-09-07 default camera orientation
2020-09-07 first step towards servo config file
2020-09-13 servo configs as json!
2020-10-16 nevermind, not gonna work, too slow =(
    [xbox_control_resource.py]
2020-11-22 Fix control point size
    C1 is inside the robot near joint 2, has to be bigger, c3 is the gripper, doesn't have to be so big.
2021-03-05 not windows doesn't imply Linux...
    [os_utils.py]
2021-03-07 remove print statement
2021-03-08 prevent trivial error during the copy() call
    The obstacle slowly climbed higher and higher....
    [obstacle.py]
2021-05-10 update code to reflect new gripper which uses a dynamixel servo
2021-05-12 let's not switch it up, feed the arguments in the right order...
2021-05-14 don't set the goal current if there is none
2021-05-14 add goal current to the servo class
2021-05-14 new gripper code the gripper is now a dynamixel
2021-05-14 playing around with pid
2021-05-14 new urdfs
    [arm.stl, base.stl, fred_new.urdf, fred_with_spheres_new.urdf, gripper.stl, gripper_servo.stl, joint2.stl, joint3.stl]
2021-05-14 use some guid stuff to calibrate the robot
2021-06-01 improve calibration script
2021-06-01 these buttons are not toggle, but continous
2021-06-03 fix small bug
    -10 gets reported as MAX_INT -10....
    [servo_handler.py]
2021-06-03 no more servo configs in json form, pure python
    And yes, now we have to reload the entire program for these changes to take effect instead of dynamically reloading it at runtime, but I never implemented that anyway so who cares!
2021-06-03 simple script to figure out the offsets of servo 2 and 3 due to gravity
2021-06-03 more servo tests
2021-06-09 create seperate folder for calibration routines
2021-06-13 actually disable servos on failure
    [dynamixel_robot_controller.py]
2021-06-13 don't yeet the gripper
2021-06-17 better board
2021-06-20 first attempt at camera control UI
2021-06-20 add a button for the image handler
2021-06-20 new calibration values
2021-06-20 let's keep track of the aruco image handler
2021-06-20 new stl
    [joint3.stl]
2021-06-20 make the dictionary a variable so we can generate multiple different boards
2021-07-06 useful script to calibrate the camera
2021-07-06 use the previous location of the board if it can't be found
2021-07-07 implement board to board tracking for the robot arm
2021-07-07 add print statements for feedback
2021-07-15 make sure everything shuts down if the physical robot has no power
2021-08-09 fix obstacle avoidance, cleanup and such
    [global_constants.py]
2021-08-21 extra safety, start the robot with low current so it can't wreck itself
2021-08-22 set the value of the operating mode and get rid of the current control
2021-08-23 only save the stationary boards location, don't override it with the moving one...
2021-08-23 make it a bit nicer by keeping track of the running thread
2021-08-23 filter the new pose using a Kalman filter, no more jitters!
2021-08-25 enable the jitters at the press of a button!
2021-08-28 touch the ground why don't you?
2021-08-29 add button to change flip status
2021-08-29 more reading material
2021-09-06 first attempt at reading the angle from the arduino directly
2021-09-06 start without binding anything to the keyboard in start_no_keyboard
    [gravity_compensation.py]
2021-09-06 new calibration scripts
2021-09-08 fix gravity compensation functions, the frequency has to be 1, basic torque calculations...
    [gravity_compensation_with_math_angle2.py, gravity_compensation_with_math_angle3.py]
2024-06-12 reconfigre servos
2024-06-21 change start pos
    The robot has springs which caused the previous start pos to cause a jump when the robot was turned off
2024-06-21 open gripper slowly
    sudden jumps in gripper position cause the servo to die
2025-05-08 wip position recorder
    [fred_with_spheres_new.urdf]
2026-10-17 Load the servo configuration from a yaml file
    The servos were configured with positional arguments in servo_configurations.py,
    which made it easy to mix up values and shared one set of mutable Servo objects
    between all robot instances. They are now described in servo_config.yaml with
    named fields, angles in degrees and the bus each servo is on, and loaded and
    validated by servo_config.py, so a typo fails at startup instead of when the
    arm moves. Every load creates new Servo objects.
    The controller takes a ServoConfig (loaded from the yaml by default) instead of
    a list of servos, and gets the buses from it instead of a hard-coded constant.
    The yaml files are excluded from the *.yaml ignore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
2026-10-17 Stop the robot before a servo gets too warm for the PLA parts
    The servos only shut down by themselves at 80C (70C for the gripper), and then
    go limp. The robot is printed in PLA, which softens around 55-65C, so the
    controller now checks the temperatures against a software limit from the servo
    configuration: above the warning temperature (45C) a warning is logged once,
    above the limit (50C) get_overheating_servos reports the servo so the robot
    can be stopped while all servos still work, and the servos can't be enabled
    until they cooled down.
2026-10-17 Make the gripper non-blocking and let it squeeze harder
    set_gripper moved the gripper in steps of 0.1s, which blocked the caller for
    up to 10s and could make the gripper lock up. It is now a single goal position
    write, the servo moves smoothly at its own profile velocity. get_gripper_state
    reads the actual state of the gripper.
    The goal current of the gripper is raised from 50mA to 400mA, so it grips
    firmly. gripper_test.py measures how the squeeze current depends on how far the
    target is beyond the object (about 2mA per position with p=500); squeezing a
    pen was tested without hardware errors or heating up to about 580mA.
2026-10-17 Rework the xbox controller: one thread moves the robot, checked moves
    - Start and stop move the robot in a straight line planned with
    plan_move_to_pose. The start move is planned before the servos are enabled,
    so the robot does nothing when the start pose can't be reached, and it can
    be stopped halfway.
    - The xbox robot controller owns the running state; the api asks it with
    is_running instead of keeping its own flags, which got out of sync when the
    control loop crashed. A lock makes sure start and stop don't overlap and the
    stop flag is an Event, so stopping doesn't wait for the main lock.
    - Only the control loop thread moves the robot. Find center is queued as a
    command for t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
2026-10-17 Extend the tests of the servo stack
    The controller tests use their own servo configuration instead of the real one,
    and compute the expected positions from the offsets, so recalibrating the robot
    doesn't break them. New tests cover the packets the servo handler sends (byte
    layout of the pid and profile writes, one sync read per bus, signed positions),
    clamping, partial read failures, rebooting, operating mode changes, hardware
    error decoding, the temperature limits, port discovery and the latency timer
    detection.
2026-10-17 Extend the tests of the kinematics and movement planning
    Inverse and forward kinematics round trips at the edges of the workspace and
    near the singularities, both wrist flips, and the jacobian transpose of the end
    effector against a numerical jacobian. Every safety check of the straight line
    planner is tested on its own, as well as the smoothness and timing of planned
    moves, the spline workspace checks, the movement classes and the obstacles.
    Tests that only printed now assert.
2026-10-17 Extend the tests of the xbox control
    New tests for the flask endpoints, starting and stopping at the same time,
    stopping during the start move and during playback, commands not surviving a
    restart, crashes of the control loop, all buttons, the gripper lead at both
    ends, the workspace limits and velocities of the pose updater, and parsing the
    gamepad events.
2026-10-17 Make the camera and reinforcement learning tests run, and extend them
    - The camera tests find their resources independent of the working directory.
    The aruco image handler tests skip because the installed OpenCV 4.9 no
    longer has the aruco functions image_handlers.py uses, the tests stay so
    they run again after porting it.
    - The robot env tests skip when tf_agents isn't installed.
    - New tests for the camera geometry helpers, the occupancy grid, the repulsive
    and attractive forces, the scenarios and the pose recorder.
2026-10-17 Update the readme and add the gravity compensation handover
    The readme now mentions the P1S and the PETG-CF arm between joints 2 and 3,
    and how to run all tests (most test files don't match the default discover
    pattern). The handover describes the plan for gravity and spring compensation.
2026-10-19 Add a script that measures the servo offsets with the jig
    calibration/measure_offsets.py reads the servos a jig holds at known angles
    (by default servo 1 at 90 degrees, servos 2 and 4 at 0), computes the offset
    as the raw position minus the calibrated position of that angle and writes it
    to servo_config.yaml, keeping the comments. It refuses when the torque is on,
    when the readings jitter or when the raw range of a joint would leave 0-4095,
    and warns about a homing offset in the servo (register added to the config).
2026-10-19 Recalibrate the offsets of servos 1 and 2 with the jig
    The encoders of servos 1 and 2 sit on the joint shafts behind the 3:1 belts,
    so their zero moves with every reassembly. Measured in the jig on 18 October:
    servo 1 reads 2394 at 90 degrees (offset 346, was 354), servo 2 reads 457 at
    0 degrees (offset -567, was -464, 9.1 degrees off).
2026-10-19 Load the link lengths of the robots from robot_config.yaml
    global_constants builds dynamixel_robot_config and simulated_robot_config
    from src/robot_config.yaml through src/robot_config.py, which validates the
    file like the servo configuration loader does. d1 changes from 13.92 to 15.7.
2026-10-19 Build the urdf of the simulated robot from fred.xacro and robot_config.yaml
    fred.xacro described the 2021 geometry while the simulation loaded a hand
    edited fred_with_spheres_new.urdf with d1 = 0.1395. The xacro now describes
    the current geometry with the link lengths as arguments, and
    src/simulation/build_urdf.py renders fred_with_spheres_new.urdf and
    fred_new.urdf from it with the lengths of robot_config.yaml (xacro 2.1.1,
    pinned in requirements.txt). tests/simulation_tests loads the result in
    pybullet and checks the chain against the yaml, and fails when the files are
    not rebuilt after a change.
2026-10-19 Revise the handover documents and add the servo offset calibration instructions
    The controller rework handover is checked against the code: every open issue
    has a path and line numbers, eleven issues are added, and the architecture
    sections describe what a maintainer needs (start up, conventions, endpoints,
    threads, the scripts that move the arm). The gravity compensation handover is
    rewritten for this robot: joints 4-6 are XC430 servos without current
    sensing, the encoders of joints 1 and 2 sit on the joint shafts, the spring
    loads joints 2 and 3, and the 2021 compensation and its data are described.
    The Pinocchio regressor is replaced by a closed form one for this arm.
    Calibrating the serv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
2026-10-19 use new fred urdf
2026-10-20 Check the workspace on the robot and merge the movement modules into one planner
    The workspace check lives in one place, src/utils/workspace.py, and every robot exposes it as
    check_workspace(angles) and workspace_violation(angles) with its own workspace_limits and link lengths.
    move_servos checks nothing so it stays fast; whoever moves the robot checks first: the planner checks every
    step, the xbox control loop and the board to board controller hold their pose while a pose outside the
    limits is asked for. The wrist centre is checked against wrist_z_min when the limits have one.
    src/utils/cartesian_movement.py and src/utils/movement_utils.py did the same job twice; they are merged into
    src/u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
2026-10-20 Keep the gripper tip above -1cm and the wrist centre above 1.5cm
    The single z_min of -5 let the wrist servo body, which hangs about 1.8cm below the wrist centre when the
    gripper points up, go through the table. The tip may now come down to -1cm so the fingers can rest on the
    table; the wrist centre has its own limit, wrist_z_min = 1.5cm, just under its resting height with the wrist
    servo lying on the table, so moves can still start from rest. The 1.5cm is an estimate, to be measured on
    the arm at rest.
2026-10-20 Compensate the static load of gravity and the spring on the servos
    Each arm servo can carry a static load compensation in servo_config.yaml: basis terms (constant, cos_q2,
    sin_q2, sin_phi, cos_phi, wrist_reach, wrist_pitch, wrist_roll, spring_dl) with a coefficient each, optionally
    split by the direction the joint moves in (Coulomb friction), plus the geometry of the spring between the
    housings of servos 2 and 3, whose extension loads both joints. StaticCompensation evaluates the terms from the
    angles of the whole arm, Servo adds the positions to its target (the direction only turns around beyond a
    deadband of 3 positions) and ServoHandler keeps the compensated target inside the physical ran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
2026-10-20 Update the robot controller handover for the workspace check and the merged planner
    The kinematics section describes the robot-owned workspace check, the two z limits and the planner API of
    src/utils/movement.py with its speed stretching. Open issues 1, 4, 14, 20 and 21 match the merged module: the
    _init__ typo is gone, move_from_current_angles raises on a failed read, the playback no longer counts under
    issue 21, and a slow joint space move between differently flipped poses is accepted. The test count and the
    commit range are current.
2026-10-20 Build the robot in one place: get_robot sets up the bus and hands it to the controller
    global_objects.get_robot() is the only place that builds the robot. The server resources, the calibration
    scripts and robot_move_test.py all call it, so what the robot is (the simulation, or the real arm mirrored in
    the simulation) is decided there and nowhere else. It takes no arguments: the usb adapter of the servos is
    always found automatically, so the port argument of get_robot, the dynamixel_robot_arm_port constant and the
    port parameter of DynamixelRobotController are gone. The debug route of the server used to pass 'COM5', which
    evicted the running robot from the cache and built a second one.
    get_r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
2026-10-20 Keep the simulation headless unless the server shows it
    global_objects.configure(show_simulation) decides once per process whether the pybullet window opens, before
    the robot is built; configuring afterwards raises. start_server turns the window on, the calibration scripts
    and robot_move_test.py call nothing and get a headless mirror of the arm.
2026-10-20 Skip the repulsive vector test until the control points of the new urdf are checked
    test_repulsive_vectors fails since the simulation loads fred_new.urdf (cfdc00d): control point 2 gets no
    repulsive vector along x next to the obstacle.
2026-10-20 Start the simulation only once the real robot answers
    657f4e5 started the simulation before setting up the servos, so it also ran when they didn't answer. Back to the
    real robot first, as the comment in get_robot says. The fake controller of the get_robot tests takes the servo_config
    that get_robot passes since 03e6ee6.
2026-10-20 Let ArduinoAngleReader.stop() stop the reading thread
    stop() set _running to True instead of False, and joined the thread while holding the lock the thread needs to see
    the flag, so it hung either way. The flag is now set under the lock and the thread joined outside it. Tested on
    pyserial's loopback port; the stop test fails on the old code.
2026-10-20 Keep finding the center when the recorded poses define none
    get_center returns None for two poses at different heights, parallel or not level, and set_center indexed it, so the
    Y button raised a TypeError in find-center mode. The poses are now dropped with a warning and find-center mode
    continues, so two new poses can be recorded.
2026-10-20 Handle unreadable current angles instead of crashing on None
    get_current_angles() returns None when the servos can't be read, and three places used it unchecked:
    - Movement.is_robot_at_start_pose now raises a MovementException, so a move is refused like when the robot is not
    at its start pose, instead of a TypeError from np.allclose
    - get_current_gripper_position returns None
    - move_to_pose reads the current angles when they aren't known yet (before the first move, when the initial read
    failed without safety checks) and raises a DynamixelError if that read fails too
2026-10-20 Make ServoPositionRecorder.write work
    It joined lists of numbers with " ".join, which raises a TypeError. It now writes one line per recording: the id,
    current and target position of each servo.
2026-10-20 Port the camera code to the aruco API of OpenCV 4.7+
    OpenCV 4.7 removed the module-level aruco functions, so with the installed 4.9 the image handlers couldn't even be
    constructed and the camera control couldn't start. The calls now go through helpers in src/camera/util.py built on
    ArucoDetector, CharucoDetector, matchImagePoints, solvePnP and calibrateCameraExtended; drawAxis became drawFrameAxes.
    The handler interfaces and vector shapes are unchanged.
    Checked against the old code: opencv-contrib-python 4.6.0.66 in a separate venv ran the unchanged handlers on the
    recorded test images. The board poses, the board-to-board pose and the marker poses on 2_boards.png are identical,
    and aruco_le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
2026-10-20 Pass the chessboard flags by name and save the calibration as lists
    findChessboardCorners got its flags positionally in the corners argument, so they weren't applied, and
    camera_calibration.py passed ndarrays to json.dump, which raised after the whole calibration had run. Untested, the
    scripts need a camera.
2026-10-20 Small fixes the type check pointed out
    - BoardToBoardRobotController: the should_filter attribute shadowed the should_filter() method; it is now
    _should_filter and the control loop reads it through the locked method
    - XboxController stores a bool for the start button, it stored 0 instead of False
    - Servo2 and Servo3 raise a ValueError without dynamic offsets instead of a TypeError
    - sim.py calls create_move with the right arguments and exits when the arc is outside the workspace
    - scratches/json_dumping.py passes the SplineMovement arguments in the right order
    - robot_move_test.py stops with a message when use_simulation is set, it needs the real robot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
2026-10-20 Rework the xbox pose updater: real time steps, a symmetric ramp, its own angular speed
    XboxPoseUpdater no longer checks the workspace itself, the control loop's robot.workspace_violation check is
    the only one. A step covers the time that really passed since the previous step (the loop measures it, capped
    at MAX_STEP_TIME so a stall never makes the pose jump), so the stick speeds hold at any loop pace. Every axis
    ramps towards the speed the stick asks for by the same acceleration, so easing off a stick ramps down instead
    of dropping; the right stick has its own maximum_angular_speed instead of a tenth of the linear speed. The
    lock went, nothing is derived from maximum_speed ahead of time. The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
2026-10-21 Pin the packages of the venv in requirements.txt
    requirements.txt only had the robot controller and mypy, so a fresh clone couldn't run the app, the tests or its own
    pre-commit hook. It now pins every package the code and the tests import, at the versions of the venv. A fresh venv
    installed from it passes the type check and the tests. tf-agents, tensorflow-probability, gin-config, keyboard,
    imageio and Arduino aren't installed and are listed in a comment.
2026-10-21 Range check the servo values, detect failed reboots, sort servo ids as numbers
    The open issues 5, 12, 16, 17 and 19 of the robot controller handover:
    - to_bytes raises when a value doesn't fit instead of masking it, and load_servo_config checks every register value
    (pid, profile, goal current, positions, offset) against the size of its register
    - a servo whose reboot command fails counts as not rebooted, even when it answers a ping afterwards
    - the Servo2/Servo3 lookup takes the nearest table key, -0.0 and angles between two keys no longer raise KeyError
    - servo ids are sorted as numbers, 7 before 10
    - ServoPositionRecorder.record took servos 2-7 as 1-6; it starts at index 0, where the con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
2026-10-21 Refuse to enable instead of waiting on input when servo 1 or 2 is out of range
    The safety check printed DANGER and blocked on input() in whatever thread started the robot, so a web request hung on
    stdin (issue 18). It now refuses with a logged error that says where the servo is and to move the arm by hand, and
    reports both servos when both are out of range. The thresholds are angles now, the ones raw 0 and 2500 gave with the
    calibration of 20 October, so recalibrating servo 1 or 2 no longer moves where the check fires.
    Also: the TODO to set the position limits in the servos is replaced by a note on why the range is enforced by clamping
    the targets instead, and robot_move_test.py moves to th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
2026-10-21 Fix the joint 2 term of the Jacobian, keep the euler matrix when a pose is copied
    The open issues 1, 3 and 11 of the robot controller handover:
    - jacobian_transpose_on_f used c2 instead of c1 in the joint 2 term of control points 1 and 2 (also in the copy in
    custom_policy.py); against a finite difference Jacobian they were off by up to 47, now all three control points
    match to 1e-5. This feeds the repulsive forces of the obstacle avoidance.
    - Pose.__copy__ keeps euler_matrix, Pose.__eq__ compares the orientations instead of raising when one side has a
    matrix, and reset_orientation drops the matrix, which would otherwise override the zeroed angles
    - get_repulsive_forces_world allocates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
2026-10-21 Report a missing camera calibration instead of exiting, keep the calibrations in one place
    get_calibrations called sys.exit() when the file was missing, in the request thread of /camera/start_aruco (issue
    26). It raises FileNotFoundError now, with the path and the script that makes it, and the camera endpoints answer
    with the error. The handlers use calibration_data_charuco.json when it exists, otherwise calibration_data.json.
    All calibration scripts write to src/camera/calibration/ instead of a calibration/ relative to where they are
    started, and camera_calibration.py writes calibration_data.json instead of a .txt nothing read. The two ChArUco
    scripts passed the image size as (height, widt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
2026-10-21 Serve the robot to this machine only and refuse posts from other web pages
    The server listened on 0.0.0.0 with CORS for every origin and no authentication (issue 8): anyone on the network,
    or any web page, could start, stop or disable the arm. It listens on 127.0.0.1 now, CORS allows only the two origins
    the UI uses, and posts that carry another Origin are refused with a 403, since CORS alone doesn't stop a page from
    sending a simple post. The debug route /test2, which built the robot on a GET, is removed (issue 25).
2026-10-21 Check every stick step, turn the wrist over slowly, leave the flip to the a button
    The stick control sent the inverse kinematics of every pose straight to the servos (issues 4 and 21). Now
    current_pose is the commanded pose and the loop sends angles that turn towards its angles at 95% of
    recommended_max_servo_speed; the gamepad waits until they arrive. So the arm slows down near a singularity instead of
    stopping, and when the wrist has to turn over, joints 4 and 6 turn by pi at that speed. A step is skipped, the arm
    holds, when the position can't be reached or check_move refuses it (workspace limits, servo ranges). The inverse
    kinematics gives angles from -pi to pi; a turn of almost 2 pi is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
2026-10-21 Update the handovers: the open issues fixed on 20 and 21 October
    Only issue 10 (the arm drops on a stop, it needs a rest pose measured on the arm) and restored recordings that mix
    flips (part of issue 4) are still open in the robot controller handover.
2026-10-21 Make the safety check tests independent of the calibration of the robot
    The tests read the servo_config.yaml of the robot and expected raw 0 and 2500 at the edges of the safe ranges, which
    only held for the offsets of 20 October, so recalibrating servo 1 or 2 broke them. They use the test config now and
    compute the edges from the safe angles with the calibration of the servo; one test keeps the meaning of the angles:
    with the offsets of 20 October the edges are raw 0 and 2500.
2026-10-21 Trim the handovers to what is still open or not in the code
    The bugs handover was a record of fixes that are in the git log now; its open items, the checks that need the robot
    or the camera, moved to the robot controller handover. That one loses the lists of what was fixed on 20 and 21
    October and the stale suggestion to set the position limits in the servos; it keeps the measured robot, how to run
    it, the architecture and the two open issues. The gravity handover loses the corrections to its first version.
2026-10-21 Rename the wired gamepad to Xbox360Controller, add XboxOneController for the wireless one
    XboxController and its file and tests are now Xbox360Controller. Its event dispatch moved out of the monitor loop
    into _handle_event, unchanged, so the wireless controller can reuse it.
    XboxOneController is not used anywhere yet. On Windows the wireless controller is an xinput device, so it is read
    like the wired one. On Linux the inputs library doesn't find Bluetooth devices, so it is read with evdev (not
    installed, ignored by mypy) and its codes and ranges are turned into those of the wired controller: the right stick
    is ABS_Z/ABS_RZ, the triggers ABS_BRAKE/ABS_GAS with 0..1023, the sticks 0..65535,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
2026-10-23 Ignore the csv recordings of the calibration scripts
    record_static_load, tune_servo_gains and check_supply_voltage write their samples next to where they run.
2026-10-23 Read the state block, gains, profile, goal pwm and torque of the servos; refuse gains above 16383
    ServoHandler.read_state reads addresses 120-146 of every servo in one packet per bus (realtime tick, moving status,
    pwm, current or load, velocity, position, the velocity and position trajectory of the profile, voltage and
    temperature), picking the fields out of the block with the sdk's getData, which the old sync read could not.
    read_pid, read_profile, read_goal_pwm and read_torque_enabled read settings back, since a sync write is not
    acknowledged; set_profile and set_goal_pwm set one servo without touching its configured values. The servos drop a
    gain above 16383 silently, the handler and the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
2026-10-23 Add tune_servo_gains.py: P and D of one joint from steps with the profile off under a goal pwm clamp
    Per pose a baseline at rest, then trials at P rising by 1.3 from the yaml value: the rest ripple, steps of the goal
    sized to stay under a goal pwm clamp with the servo's profile switched off so the loop itself answers, and a
    streamed planned move with the production profile. The first trial that overshoots, rings, does not settle or raises
    the ripple or the pwm noise at rest (the part the position does not explain, per unit of P) is the knee; 0.65 times
    the knee is recommended per pose, the smallest over the poses is the P of the joint, and D is tried at that P where
    the step overshoots. Live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
2026-10-23 Add check_supply_voltage.py: the input voltage along the servo chain at rest, holding poses and during a move
    Samples all seven servos in one packet per bus, reports min, mean and max per phase and servo, the drop along the
    12 V chain and against the reference of 21 October, flags readings outside the rated range of each model, and says
    whether the supply, the leads or a connector loses the voltage. Reads are retried and the failures counted per
    phase, since one corrupt status packet under load ended the first run.
2026-10-23 Spring removed from the robot: the spring term is off by default in the static load model
    The spring between the servo 2 and 3 housings tripped the overload protection of servo 3 in a static hold of the
    upper arm horizontal (0.81-0.86 A with it, 0.75 A without, the same hold then ran for minutes) and joint 2 holds the
    stretched arm at 15 % of its stall current without it, so it came off on 23 October 2026. term_names(joint) is the
    gravity model, term_names(joint, spring=True) adds the spring columns, which the fit script and the yaml parser only
    do when the yaml has a spring section.
2026-10-23 Delete the 2021 gravity recording scripts
    record_going_up/down and their servo 3 variants needed the keyboard package and the Arduino angle sensor and moved
    servos 2 and 3 at import; record_static_load.py replaces them.
2026-10-23 Document the gain tuning, the supply check, the spring removal and the workspace limit
    Tuning the servo gains.md: why the gains come before the static load, why I stays 0, the registers read on 21
    October, the method and its criteria and abort rules, the order of joints, the poses, how to run it, what the
    review changed, and the literature. Workspace limits.md: the 57 cm sphere is measured from the ground rather than
    the shoulder, parked. The gravity handover loses the spring (Step 3 keeps the measurements of 23 October) and gains
    the friction of joint 2 and the gains-first paragraph; the rework handover's tools table has the new scripts.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
2026-10-23 Raise the workspace radius from 57 to 60 cm
    The sphere is measured from the ground under the base; at 57 it sat 0.8 cm beyond a horizontally stretched arm and
    refused the tuning poses with an 8 degree excursion. See Workspace limits.md.
2026-10-23 Install evdev on Linux only, for the wireless xbox controller
2026-10-23 Replace the 2021 safety check by the calibrated range of the yaml with a 5 degree margin
    servo_1_check and servo_2_check compared the raw position with 0 and 2500, a rule from the motor-side encoder days
    translated into fixed angles, which forbade 99 to 180 degrees of the base. enable_servos now refuses when an arm
    servo rests more than CALIBRATED_RANGE_MARGIN_DEGREES outside the calibrated range of the yaml, offset included,
    through get_servos_outside_calibrated_range, which gained the margin. Outside the range the reported angle is
    clamped and the first move would jump, which is the danger the check is for. Servo.calibrated_range replaces the
    clamp of 2 to the 31.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
2026-10-23 Raise the voltage abort of the gain tuning to 1.5 V
    The supply dips by more than 0.7 V during the steps, which ended trials for a reason that says nothing about the
    gains. The tests read the temperature and voltage limits from AbortLimits instead of hardcoding them.
2026-10-23 Tune D on the resting error band, always run the D grid, full clamp on the unloaded joints
    - run_d_phase tries every D of the grid plus the yaml D at every pose; the shortcut after a D = 0 trial
    without overshoot is gone.
    - choose_d takes the mean |final - goal| of the steps (TrialResult.mean_abs_error) as a sixth element: a D
    above the reference (D = 0, or the smallest passing D) is only preferred when it beats it by a position
    in overshoot or resting error, or removes a ring, without being a position worse in the other; then the
    least resting error, overshoot, rings, D. On joint 6 (tune_joint6_20261023_1822) every D passed within
    a position of overshoot and 1100 won on 0.3 positi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
2026-10-25 Delete the 2021 gravity compensation scripts
    gravity_compensation.py (keyboard driven, needed the keyboard package and the Arduino angle sensor) and the two
    offline curve fits of the 2021 data; record_static_load.py and fit_static_load.py replace them, the data stays in
    calibration/results.
2026-10-25 Tuning: the temperature abort follows the yaml limit, the output directory is created, temperatures are printed
    --max-temperature defaults to the temperature_limit of servo_config.yaml instead of a fixed 50 C. The output
    directory of the tuning and the supply check is created before the servos are enabled and taken relative to the
    working directory, which a PyCharm run configuration may set elsewhere. get_servo_temperatures on the controllers,
    printed at the end of a run.
2026-10-25 Add plot_tuning.py: the knee of a gain sweep, the D sweep and the step responses from the csv files
    One panel per acceptance criterion against P on a log axis with the limit drawn in it, failed trials hollow, the
    knee and the recommendation as vertical lines, several runs of a joint in one figure; the D sweep with the resting
    error band; the first step up of every trial as a fraction of the step. Tested on the csv output of the simulated
    session.
2026-10-25 Turn a wrist roll the long way round at the seam of its range instead of holding it there
    Since 21 October a flip of the inverse kinematics across plus or minus 180 degrees on joints 4 and 6 was turned
    into an angle just past the end of the range, which the range check held; before that it was a full turn at full
    speed. The angles of the inverse kinematics are now taken as they are, and the walk that already turns the wrist
    over by pi at the joint speed limit turns the joint almost a full turn through the middle of its range, where the
    cable is unwound, while the gamepad waits. unwrap_towards is gone.
2026-10-25 Gains of joints 1, 2, 5 and 6 from the tuning runs of 23-25 October, temperature warning 50 and limit 55
2026-11-11 Workspace limits: the reach of the wrist from the shoulder instead of a sphere, the gripper tip down to -2 cm
    The tip had to stay within a sphere of 60 cm around the origin on the ground. The arm reaches from the shoulder,
    15.7 cm above it, so the sphere never limited the stretched arm and capped the height at 60 cm while the arm reaches
    69.7 cm. Now the wrist centre has to stay within wrist_reach_max = 41.8 cm of the shoulder, the elbow bent at least
    about 11 degrees (40 cm would keep it bent 35 degrees and refuse the reach pose of the gain tuning); radius_min stays
    for the base. Nothing hangs above the robot, so there is no maximum height. The camera controller's own copy keeps
    only the ra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
2026-11-11 Calibration scripts: try a failed status read of the servos again before stopping the run
    check_servos read the hardware errors and the temperatures once, so one corrupt status packet on the bus ended a
    gain tuning run halfway (joint 2 on 25 October 2026). read_status tries a read up to READ_ATTEMPTS = 3 times, like
    the sampling of the tuning already did; check_servos and the temperature check of the servo under test use it.
2026-11-11 Gain tuning: sweep P at every D of a grid instead of D at one P
    Damping adds phase margin, so the P where a loop starts to overshoot depends on D (joint 2 at elbow_out on 25
    October 2026: the knee was at 2000 with D 0 and 2600 with D 500). The P sweep used to run at the yaml D only, and D
    was tried afterwards at the resulting P, so the yaml D decided how far P got and a run that stopped early tried no
    D at all. Now P is swept at every D of a ladder (0, then --d-start and steps of --d-factor, plus the yaml D), one D
    at a time over every pose, so a run that stops keeps whole D gains. The D with the highest P of the joint wins;
    D gains that share it are compared at that P with the existing over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
2026-11-11 Servo handler: try a failed sync read of a bus again, and log how it failed
    A corrupt or missing status packet now and then made a read of the whole arm fail, and with it a tuning run or a
    recording. A sync read of a bus is now tried up to 3 times (the sdk clears the port before every packet, so a
    failure doesn't spill into the next attempt). Every failed attempt is logged with the time it took: at the packet
    timeout the reply didn't arrive in full (lost on the wire, or the pc or usb late), well before it the reply had
    wrong bytes. The sdk zeroes packet_timeout when it runs out, so BlockingPortHandler keeps the value it was set to.
    The handler counts the failures, the late ones and the failu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
2026-11-11 Wrist roll and gripper: XC330-T288-T on the 12 V bus, and wrist_roll_limits.py to test them
    Servo 6 was an XL330-M288 on a 5 V step-down converter at the wrist after the rebuild of November 2026. The converter
    switched off when the servo braked (the energy it gave back pushed the 5 V line up), and the servo was later broken
    by 11.7 V from a converter that wasn't set yet. Servo 6 and the gripper (7) are now XC330-T288-T straight on the 12 V
    bus (model 1220, current limit 910 mA at 1 mA per unit), in current-based position mode.
    With the P of 1200 it came with and D 0 the roll swung +-115 positions around every target; on the bench it
    oscillates from P 600 without D and rests within a few pos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
